drmn4ea/mosquino.hardware/shield-gps/bom/shield-gps.xls

C:/Data/projects/mosquino/pcb/shield-gps/shield-gps.sch | 1/12/2015 10:54:26 PM | Mide Technology Corporation
Qty | Parts (Ref Des.) | Device | Value | ID (bag/kit#) | Manufacturer Part Number | Vendor Part Number | RoHS | Pop. Qty | Unit Cost: Qty1 | Unit Cost: Qty25 | Unit Cost: Qty100 | Unit Cost: Qty1000 | Board @ 1 | Board @ 25 | Board @ 100 | Board @ 1000
2 | J1, J2 | MTA08-100 |  |  |  |  |  | 2
2 | C1, C3 | C-EUC0603 | 4.7uF |  |  | 587-1242-1-ND (http://www.digikey.com/product-detail/en/LMK107B7105KA-T/587-1242-1-ND/931019) |  | 2
1 | R1 | R-US_R0603 | 10k |  |  | P10KGCT-ND (http://www.digikey.com/product-detail/en/ERJ-3GEYJ103V/P10KGCT-ND/134717) |  | 1
1 | C2 | C-EUC0603 | 100nF |  |  | 490-1532-1-ND (http://www.digikey.com/product-detail/en/GRM188R71C104KA01D/490-1532-1-ND/587771) |  | 1
1 | ANT1 | A10204_ANTENNA | A10204_ANTENNA |  |  | 627-1024-1-ND |  | 1
3 | R2, R3, R4 | R-US_R0603 | DNP |  |  |  |  | 3
1 | U1 | ISM420X_GPS | ISM420X_GPS |  | ISM420R1-C33 | 1475-1000-ND |  | 1
1 | IC1 | 24AA1025 | M24M01-DFMN6TP |  | M24M01-DFMN6TP | 497-14926-1-ND (http://www.digikey.com/product-detail/en/M24M01-DFMN6TP/497-14926-1-ND/4959874) |  | 1
5 | CTS, R, RTS, T, WO | PTR1PAD1-13 | PTR1PAD1-13 |  |  |  |  | 5
1 | U$1 | VREG_LT1761_SOT23-5 | TC1016-1.85VCTTR |  | TC1016-1.85VCTTR | TC1016-1.85VCTCT-ND (http://www.digikey.com/product-detail/en/TC1016-1.85VCTTR/TC1016-1.85VCTCT-ND/2202006) |  | 1
Totals...
