drmn4ea/mosquino.hardware/pwr-rf/bom/mosquino-power-rf.xls

Qty | Parts (Ref Des.) | Device | Value | ID (bag/kit#) | Manufacturer Part Number | Vendor Part Number | RoHS | Pop. Qty | Unit Cost: Qty1 | Unit Cost: Qty25 | Unit Cost: Qty100 | Unit Cost: Qty1000 | Board @ 1 | Board @ 25 | Board @ 100 | Board @ 1000
1 | J3 | MTA02-100 |  |  |  |  |  | 1
2 | J1, J2 | MTA05-100 |  |  |  |  |  | 2
5 | C2, C4, C6, C8, C10 | C-EUC0603 | 7pF |  | C1608C0G1H070C080AA | 445-5040-1-ND |  | 5
4 | C3, C5, C7, C9 | C-EUC0603 | 10pF |  | CL10C100JB8NNNC | 1276-1027-1-ND |  | 4
1 | C11 | C-EUC0805 | 10uF |  | CC0805ZKY5V6BB106 | 311-1355-1-ND |  | 1
1 | L1 | INDUCTOR0603 | 6.8nH |  | ELJ-RE6N8JFA | PCD1971CT-ND |  | 1
1 | D7 | DIODE-SOD523 | ESD5Z3.3T1 (DNP) |  | ESD5Z3.3T1G | ESD5Z3.3T1GOSCT-ND |  | 1
5 | D1, D2, D3, D4, D5 | DIODE_DUAL_ACACSOT323 | HSMS-285C |  | HSMS-285C-BLKG | 516-2558-ND |  | 5
1 | LED1 | LEDCHIP-LED0603 | LTST-C191TBKT |  | LTST-C191TBKT | 160-1647-1-ND |  | 1
1 | LOGO1 | OSHW-LOGOS | OSHW-LOGOS |  | n/a |  |  | 0
3 | VCP, VCP2, VOUT | PTR1PAD1-13 | PTR1PAD1-13 |  | n/a |  |  | 0
1 | D6 | DIODE-SOD523 | RB751S40 |  | RB751S40 | RB751S40CT-ND |  | 1
3 | C12, C13, C14 | CAP_TANT_D | RVA0J101MNG |  | RVA0J101MNG | 493-6670-1-ND |  | 3
2 | J4, J5 | SJ_2S | SJ_2S |  |  |  |  | 0
1 | C1 | C-TRIMM3018_12 | TZB4R200BA10R00 |  | TZB4R200BA10R00 | 490-1981-1-ND (FIXME: NON STOCK) |  | 1
1 | U2 | S-882Z | s-882z |  |  |  |  | 0
Totals...
