drmn4ea/mosquino.hardware/shield-ble/bom/shield-ble.xls

Qty | Parts (Ref Des.) | Device | Value | ID (bag/kit#) | Manufacturer Part Number | Vendor Part Number | RoHS | Pop. Qty | Unit Cost: Qty1 | Unit Cost: Qty25 | Unit Cost: Qty100 | Unit Cost: Qty1000 | Board @ 1 | Board @ 25 | Board @ 100 | Board @ 1000
2 | J1, J5 | MTA08-100 |  |  |  |  |  | 2
1 | C4 | C-EUC0603 | 1.2pF |  | CL10C1R2CB8NNNC | 1276-1186-1-ND |  | 1
1 | C5 | C-EUC0603 | 1.8pF |  | CL10C1R8CB8NNNC | 1276-2218-1-ND |  | 1
1 | C7 | C-EUC0603 | 1nF |  | CL10B102KB8SFNC | 1276-1916-1-ND |  | 1
1 | C3 | C-EUC0603 | 1uF |  | CL10F105ZP8NNNC | 1276-1041-1-ND |  | 1
1 | C12 | C-EUC0603 | 2.2nF |  | C0603C222K5RACTU | 399-1085-1-ND |  | 1
1 | L3 | L-GENERIC0603 | 3.9nH |  | ELJ-RE3N9JFA | PCD1968CT-ND |  | 1
1 | C6 | C-EUC0603 | 4.7uF |  | CC0603KRX5R6BB475 | 311-1455-1-ND |  | 1
1 | L5 | L-GENERIC0603 | 5.6nH |  | ELJ-RE5N6JFA | PCD1970CT-ND |  | 1
1 | X2 | CRYSTAL_SMD_5X3POINT2MM | 7A-16.000MAAE-T |  | NX5032GB-16MHZ-STD-CSK-5 | 644-1192-1-ND |  | 1
1 | L4 | L-GENERIC0603 | 8.2nH |  | ELJ-RE8N2JFA | PCD1972CT-ND |  | 1
1 | L1 | L-GENERIC0603 | 10uH |  | CBMF1608T100K | 587-1720-1-ND |  | 1
2 | C1, C2 | C-EUC0603 | 10pF |  | C1608C0G1H100D080AA | 445-1269-1-ND |  | 2
1 | L2 | L-GENERIC0603 | 15nH |  | CI160808-15NJ | CI160808-15NJCT-ND |  | 1
2 | C10, C14 | C-EUC0603 | 22pF |  | CL10C220GB8NNNC | 1276-2225-1-ND |  | 2
1 | R1 | R-US_R0603 | 22k |  | ERJ-3EKF2202V | P22.0KHCT-ND |  | 1
1 | C9 | C-EUC0603 | 33nF |  | CC0603KRX7R9BB333 | 311-1429-1-ND |  | 1
2 | C8, C13 | C-EUC0603 | 100nF |  | CL10F104ZA8NNNC | 1276-1011-1-ND |  | 2
1 | X1 | ANTENNA_CHIP_5MMX2MM | 2450AT42B100E |  | 2450AT42B100E | 712-1008-1-ND |  | 1
1 | C11 | C-EUC0603 | DNP |  |  |  |  | 1
1 | X3 | FC-135 | FC-135 32.7680KA-A3 |  | FC-135 32.7680KA-A3 | SE2413CT-ND |  | 1
1 | U1 | NRF8001_QFN32 | NRF8001_QFN32 |  | nRF8001-R2Q32-T | 949-NRF8001-R2Q32-T (Mouser) |  | 1
1 | LOGO1 | OSHW-LOGOS | OSHW-LOGOS |  |  |  |  | 1
2 | R, T | PTR1PAD1-13 | PTR1PAD1-13 |  |  |  |  | 2
3 | J2, J3, J4 | SJ_2S | SJ_2S |  |  |  |  | 3
Totals...
