drmn4ea/mosquino.hardware/shield-santa/bom/shield-i2c-santa.xls

Qty | Parts (Ref Des.) | Device | Value | ID (bag/kit#) | Manufacturer Part Number | Vendor Part Number | RoHS | Pop. Qty | Unit Cost: Qty1 | Unit Cost: Qty25 | Unit Cost: Qty100 | Unit Cost: Qty1000 | Board @ 1 | Board @ 25 | Board @ 100 | Board @ 1000
3 | J1, J2, J3 | MTA08-100 |  |  |  |  |  | 3
2 | R1, R2 | R-US_R0603 | 1M |  | ERJ-3GEYJ105V | P1.0MGCT-ND |  | 2
7 | C2, C3, C4, C5, C6, C7, C8 | C-EUC0603 | 100nF |  | CL10F104ZA8NNNC | 1276-1011-1-ND |  | 7
1 | C1 | C-EUC0603 | 220nF |  | CC0603KRX7R7BB224 | 311-1426-1-ND |  | 1
1 | U5 | ADXL345 | ADXL345 |  | ADXL345BCCZ | ADXL345BCCZ-ND |  | 1
1 | U2 | CC2DXXX | CC2D23S / CC2D33S |  | CC2D23S | 235-1335-ND |  | 1
1 | U4 | MPL3115A2 | MPL3115A2 |  | MPL3115A2 | MPL3115A2-ND |  | 1
1 | LOGO1 | OSHW-LOGOS | OSHW-LOGOS |  |  |  |  | 0
1 | U8 | TMP006 | TMP006 |  | TMP006AIYZFR | 296-28819-1-ND |  | 1
2 | U6, U7 | TMP101 | TMP101 |  | TMP101NA | 296-27725-1-ND |  | 2
2 | U1, U3 | TMP102 | TMP102/TMP112 |  | TMP102AIDRLR | 296-26834-1-ND |  | 2
Totals...
