drmn4ea/mosquino.hardware/shield-ant/bom/shield-ant.xls

Qty | Parts (Ref Des.) | Device | Value | ID (bag/kit#) | Manufacturer Part Number | Vendor Part Number | RoHS | Pop. Qty | Unit Cost: Qty1 | Unit Cost: Qty25 | Unit Cost: Qty100 | Unit Cost: Qty1000 | Board @ 1 | Board @ 25 | Board @ 100 | Board @ 1000
1 | C1 | C-EUC0805 | 100nF |  | GRM21BR71E104KA01L | 490-1673-1-ND |  | 1
2 | J1, J2 | MTA08-100 |  |  |  |  |  | 2
1 | U1 | ANT21TRXXX | ANTAP2 |  | ANTAP281M4IB | ANTAP281M4IB (Nu Horizons) |  | 1
2 | IO5, IO7 | PTR1TP15R | PTR1TP15R |  |  |  |  | 2
1 | J3 | SJ_2S | SJ_2S |  |  |  |  | 1
5 | J4, J5, J6, J7, J8 | SJ_3S | SJ_3S |  |  |  |  | 5
Totals...
