drmn4ea/mosquino.hardware/pwr-stepup-ti/bom/mosquino-pwr-stepup-ti.xls

Qty | Parts (Ref Des.) | Device | Value | ID (bag/kit#) | Manufacturer Part Number | Vendor Part Number | RoHS | Pop. Qty | Unit Cost: Qty1 | Unit Cost: Qty25 | Unit Cost: Qty100 | Unit Cost: Qty1000 | Board @ 1 | Board @ 25 | Board @ 100 | Board @ 1000
1 | J4 | MTA03-100 |  |  |  |  |  | 1
2 | J1, J2 | MTA05-100 |  |  |  |  |  | 2
1 | R7 | R-US_R0805 | 3.32M |  | RC0805FR-073M32L | 311-3.32MCRCT-ND |  | 1
1 | R5 | R-US_R0805 | 3.83M |  | CRCW08053M83FKEA | 541-3.83MCCT-ND |  | 1
2 | C2, C9 | C-EUC0805 | 4.7uF |  | GRM21BF51A475ZA01L | 490-1745-1-ND |  | 2
2 | R2, R3 | R-US_R0805 | 4.99M |  | RC0805FR-074M99L | 311-4.99MCRCT-ND |  | 2
1 | R4 | R-US_R0805 | 5.62M |  | RC0805FR-075M62L | 311-5.62MCRCT-ND |  | 1
2 | R6, R8 | R-US_R0805 | 6.19M |  | RC0805FR-076M19L | 311-6.19MCRCT-ND |  | 2
1 | C10 | C-EUC0805 | 10nF |  | C2012X7R1H103K | 445-1348-1-ND |  | 1
1 | R1 | R-US_R0805 | 15M |  | ERJ-6GEYK156V | P15MACT-ND |  | 1
1 | R9 | R-US_R0805 | 549K |  | ERJ-6ENF5493V | P549KCCT-ND |  | 1
1 | U1 | BQ25504 | BQ25504 |  | BQ25504RGTT | 296-29741-1-ND |  | 1
1 | T1 | NMOSSOT23 | IRFML8244TRPBF |  | IRFML8244TRPBF | IRFML8244TRPBFCT-ND |  | 1
1 | J5 | SJ_2S | SJ_2S |  |  |  |  | 1
1 | J3 | SJ_3S | SJ_3S |  |  |  |  | 1
1 | L1 | SDR0604 | 22uH |  | SRR5028-220Y | SRR5028-220YCT-ND |  | 1
1 | VOC | TPB1,27 | TPB1,27 |  |  |  |  | 0
Totals...
NOTE: BOM assumes solar input (MPPT=~0.8) and a LiPol or equivalent battery as storage device. For other configurations, please refer to the schematic for appropriate resistor values.
