drmn4ea/mosquino.hardware/pwr-stepup/bom/mosquino-power-stepup.xls

Qty | Parts (Ref Des.) | Device | Value | ID (bag/kit#) | Manufacturer Part Number | Vendor Part Number | RoHS | Pop. Qty | Unit Cost: Qty1 | Unit Cost: Qty25 | Unit Cost: Qty100 | Unit Cost: Qty1000 | Board @ 1 | Board @ 25 | Board @ 100 | Board @ 1000
1 | U2 | MAX9120 |  |  | MAX9120EXK+T | MAX9120EXK+TCT-ND |  | 0
1 | J3 | MTA03-100 |  |  |  |  |  | 1
2 | J1, J2 | MTA05-100 |  |  |  |  |  | 2
1 | L1 | SDR0604 |  |  | 744052100 | 732-1035-1-ND |  | 1
2 | R2, R4 | R-US_R0805 | 0 |  | ERJ-6GEY0R00V | P0.0ACT-ND |  | 2
1 | R8 | R-US_R0805 | 2.55M |  | RC0805FR-072M55L | 311-2.55MCRCT-ND |  | 1
2 | R3, R6 | R-US_R0805 | 4.7M |  | ERJ-6GEYJ475V | P4.7MACT-ND |  | 2
2 | C1, C2 | C-EUC1206 | 22uF |  | C3216Y5V1A226Z | 445-1393-1-ND |  | 2
3 | C3, C4, C5 | C-EUC0805 | 100nF |  | GRM21BR71E104KA01L | 490-1673-1-ND |  | 3
1 | T1 | NMOSSOT23 | IRFML8244TRPBF |  | IRFML8244TRPBF | IRFML8244TRPBFCT-ND |  | 1
2 | R1, R5 | R-US_R0805 | DNP |  |  |  |  | 2
1 | U1 | L6920 | L6920DTR |  | L6920DTR | 497-3368-1-ND |  | 1
1 | IC1 | OPA344N-SOT23 |  |  | MCP6546T-I/OT | MCP6546T-I/OTCT-ND |  | 1
1 | D1 | DIODE-SOD123 | MMSD301T1G |  | MMSD301T1G | MMSD301T1GOSCT-ND |  | 1
1 | D2 | ZENER-DIODESOD80C | zener 3.6V |  | BZV55C3V6-TP | BZV55C3V6-TPMSCT-ND |  | 1
Totals...
