drmn4ea/mosquino.hardware/pwr-lipol/bom/mosquino-power-lipol.xls

Qty | Parts (Ref Des.) | Device | Value | ID (bag/kit#) | Manufacturer Part Number | Vendor Part Number | RoHS | Pop. Qty | Unit Cost: Qty1 | Unit Cost: Qty25 | Unit Cost: Qty100 | Unit Cost: Qty1000 | Board @ 1 | Board @ 25 | Board @ 100 | Board @ 1000
1 | BAT | MTA02-100 |  |  |  |  |  | 1
2 | D1, D2 | CGRM4001-G | 1n4148 |  | CGRM4001-G | 641-1328-2-ND |  | 2
4 | J1, J2, J3, J4 | 100MIL_5X1_PTH | 100MIL_5X1_PTH |  |  |  |  | 4
1 | C1 | C-EUC0805 | 100nF |  | GRM21BR71E104KA01L | 490-1673-1-ND |  | 1
1 | R1 | R-US_R0805 | 180 |  | ERJ-6GEYJ181V | P180ACT-ND |  | 1
1 | T1 | NMOSSOT23 | IRFML8244TRPBF |  | IRFML8244TRPBF | IRFML8244TRPBFCT-ND |  | 1
1 | U1 | LTC4071MS8E | LTC4071MS8E |  | LTC4071EMS8E#PBF | LTC4071EMS8E#PBF-ND |  | 1
1 | B1 | PGEB201515_BATTERY | PGEB201515_BATTERY |  |  |  |  | 1
1 | J5 | SJ_2S | SJ_2S |  |  |  |  | 1
2 | J6, J7 | SJ_3S | SJ_3S |  |  |  |  | 2
Totals...
