drmn4ea/mosquino.hardware/pwr-pelt/bom/mosquino-pwr-peltier.xls

Qty | Parts (Ref Des.) | Device | Value | ID (bag/kit#) | Manufacturer Part Number | Vendor Part Number | RoHS | Pop. Qty | Unit Cost: Qty1 | Unit Cost: Qty25 | Unit Cost: Qty100 | Unit Cost: Qty1000 | Board @ 1 | Board @ 25 | Board @ 100 | Board @ 1000
1 | J5 | MTA02-100 |  |  |  |  |  | 0 |  |  |  |  | 0 | 0 | 0 | 0
2 | J1, J2 | MTA05-100 |  |  | PEC36SAAN | S1012E-36-ND |  | 0.33 | 1.17 | 1.046 | 0.861 | 0.58425 | 0.3861 | 0.34518 | 0.28413 | 0.1928025
2 | C3, C7 | C-EUC0603 | 1nF |  | GRM188R71H102KA01D | 490-1494-1-ND |  | 2 |  |  |  |  | 0 | 0 | 0 | 0
1 | C9 | C-EUC0603 | 1uF |  | C1608Y5V1A105Z | 445-1328-1-ND |  | 1 |  |  |  |  | 0 | 0 | 0 | 0
2 | C5, C6 | C-EUC0805 | 22uF |  | GRM21BR60J226ME39L | 490-1719-1-ND |  | 2 |  |  |  |  | 0 | 0 | 0 | 0
2 | C4, C8 | C-EUC0603 | 470pF |  | C1608X7R1H471K | 445-1307-1-ND |  | 2 |  |  |  |  | 0 | 0 | 0 | 0
1 | C1 | CPOL-USD | DNP |  |  |  |  | 1 |  |  |  |  | 0 | 0 | 0 | 0
2 | L1, L2 | LPR6235_COIL | LPR6235-752SML |  | LPR6235-752SMLB | (buy.coilcraft.com) |  | 2 | 1.06 | 1.06 | 1.06 | 0.74 | 2.12 | 2.12 | 2.12 | 1.48
1 | U1 | LTC3109GN | LTC3109GN |  | LTC3109IGN#PBF | (linear.com) |  | 1 | 6.64 | 6.64 | 5.65 | 5.65 | 6.64 | 6.64 | 5.65 | 5.65
2 | V, VE | TPTP09R | TPTP09R |  |  |  |  | 0 |  |  |  |  | 0 | 0 | 0 | 0
1 | T1 | NMOSSOT23 | IRFML8244TRPBF |  | IRFML8244TRPBF | IRFML8244TRPBFCT-ND |  | 1 | 0.41 | 0.23 | 0.1491 | 0.11411 | 0.41 | 0.23 | 0.1491 | 0.11411
Totals...
16 |  |  |  |  |  |  |  | 11.33 | 9.28 | 8.976 | 7.7201 | 7.08836 | 9.5561 | 9.33518 | 8.20323 | 7.4369125
