drmn4ea/mosquino.hardware/pwr-piezo/bom/mosquino-pwr-piezo.xls

Qty | Parts (Ref Des.) | Device | Value | ID (bag/kit#) | Manufacturer Part Number | Vendor Part Number | RoHS | Pop. Qty | Unit Cost: Qty1 | Unit Cost: Qty25 | Unit Cost: Qty100 | Unit Cost: Qty1000 | Board @ 1 | Board @ 25 | Board @ 100 | Board @ 1000
3 | J3, J4, J5 | MTA03-100 |  |  |  |  |  | 3 |  |  |  |  | 0 | 0 | 0 | 0
2 | J1, J2 | MTA05-100 |  |  | PEC36SAAN | S1012E-36-ND |  | 0.33 |  |  |  |  | 0 | 0 | 0 | 0
2 | C2, C6 | C-EUC0805 | 1uF |  | GRM219F51E105ZA01D | 490-1731-1-ND |  | 2 |  |  |  |  | 0 | 0 | 0 | 0
1 | C3 | C-EUC0805 | 4.7uF |  | C2012Y5V1C475Z | 445-1369-1-ND |  | 1 | 0.556 | 0.3712 | 0.265 | 0.1696 | 0.556 | 0.3712 | 0.265 | 0.1696
1 | C4 | C-EUC0805 | 47uF |  | JMK212BJ476MG-T | 587-1779-1-ND |  | 1 | 1.07 | 0.893 | 0.6555 | 0.418 | 1.07 | 0.893 | 0.6555 | 0.418
1 | C1 | CPOL-USD | 100uF 25V |  | UCL1E101MCL1GS | 493-3937-1-ND |  | 1 | 0.61 | 0.509 | 0.3192 | 0.2508 | 0.61 | 0.509 | 0.3192 | 0.2508
1 | L1 | INDUCTOR1210 | BRL3225T100K |  | BRL3225T100K | 587-2167-1-ND |  | 1 | 0.58 | 0.457 | 0.275 | 0.1375 | 0.58 | 0.457 | 0.275 | 0.1375
1 | C5 | C-EUC0805 | DNP |  |  |  |  | 1 |  |  |  |  | 0 | 0 | 0 | 0
1 | U3 | LTC3588_ | LTC3588_ |  | LTC3588EMSE-1#PBF | LTC3588EMSE-1#PBF-ND |  | 1 | 6.28 | 4.22 | 3.58 | 3.58 | 6.28 | 4.22 | 3.58 | 3.58
1 | T1 | NMOSSOT23 | IRFML8244TRPBF |  | IRFML8244TRPBF | IRFML8244TRPBFCT-ND |  | 1 | 0.5 | 0.2896 | 0.2335 | 0.10508
Totals...
13 |  |  |  |  |  |  |  | 11.33 | 9.096 | 6.4502 | 5.0947 | 4.5559 | 9.096 | 6.4502 | 5.0947 | 4.5559
