drmn4ea/mosquino.hardware/main/bom/mosquino.xls

Qty | Parts (Ref Des.) | Device | Value | ID (bag/kit#) | Manufacturer Part Number | Vendor Part Number | RoHS | Pop. Qty | Unit Cost: Qty1 | Unit Cost: Qty25 | Unit Cost: Qty100 | Unit Cost: Qty1000 | Board @ 1 | Board @ 25 | Board @ 100 | Board @ 1000
1 | B100 | BK885_CR1225_COIN_BATTERY_HOLDER_SMD |  |  | BK-885-TR | BK-885-CT-ND |  | 1 | 0.48 | 0.4 | 0.32 | 0.32 | 0.48 | 0.4 | 0.32 | 0.32
1 | J8 | MTA03-100 |  |  |  |  |  | 1 |  |  |  |  | 0 | 0 | 0 | 0
2 | J6, J9 | MTA05-100 |  |  |  |  |  | 2 |  |  |  |  | 0 | 0 | 0 | 0
9 | J3, J4, J5, J10, J11, J12, J13, J14, J15 | MTA08-100 |  |  |  |  |  | 9 |  |  |  |  | 0 | 0 | 0 | 0
1 | RESET-EN | SJ |  |  |  |  |  | 1 |  |  |  |  | 0 | 0 | 0 | 0
1 | F1 | R-US_R0805 | 0_FUSE |  | 0ZCE0050FF2E | 507-1519-1-ND |  | 1 | 0.39 | 0.35 | 0.25 | 0.15 | 0.39 | 0.35 | 0.25 | 0.15
1 | R2 | R-US_R0805 | 1.8M |  | ERJ-6ENF1804V | P1.80MCCT-ND |  | 1 | 0.07 | 0.07 | 0.02 | 0.01 | 0.07 | 0.07 | 0.02 | 0.01
3 | R1, R19, R20 | R-US_R0805 | 1k |  | ERJ-6ENF1001V | P1.00KCCT-ND |  | 3 |  |  |  |  | 0 | 0 | 0 | 0
1 | D2 | DIODE-SOD123 | 1n4148 |  | 1N4148W-TP | 1N4148WTPMSCT-ND |  | 1 | 0.42 | 0.28 | 0.12 | 0.04 | 0.42 | 0.28 | 0.12 | 0.04
1 | C7 | C-EUC0805 | 1uF |  | C2012Y5V1C105Z/0.85 | 445-1589-1-ND |  | 1 | 0.2 | 0.13 | 0.05 | 0.02 | 0.2 | 0.13 | 0.05 | 0.02
1 | R12 | R-US_R0805 | 3.0M |  | RMCF0805FT3M00 | RMCF0805FT3M00CT-ND |  | 1 |  |  |  |  | 0 | 0 | 0 | 0
1 | R3 | R-US_R0805 | 3.65M |  | RC0805FR-073M65L | 311-3.65MCRCT-ND |  | 1 |  |  |  |  | 0 | 0 | 0 | 0
6 | R9, R10, R13, R14, R15, R16 | R-US_R0805 | 4.7M |  | ERJ-6GEYJ475V | P4.7MACT-ND |  | 6 |  |  |  |  | 0 | 0 | 0 | 0
1 | R8 | R-US_R0805 | 6.04M |  | RC0805FR-076M04L | 311-6.04MCRCT-ND |  | 1 |  |  |  |  | 0 | 0 | 0 | 0
2 | R17, R18 | R-US_R0805 | 10k |  | ERJ-6GEYJ103V | P10KACT-ND |  | 2 |  |  |  |  | 0 | 0 | 0 | 0
2 | C6, C13 | C-EUC0805 | 10nF |  | 08055C103KAT2A | 478-1383-1-ND |  | 2 | 0.03 | 0.03 | 0.02 | 0.01 | 0.06 | 0.06 | 0.03 | 0.01
1 | C14 | C-EUC0805K | 10uF |  | C2012Y5V1A106Z | 445-1371-1-ND |  | 1 | 0.32 | 0.21 | 0.08 | 0.03 | 0.32 | 0.21 | 0.08 | 0.03
2 | R4, R5 | R-US_R0805 | 15M |  | ERJ-6GEYK156V | P15MACT-ND |  | 2 |  |  |  |  | 0 | 0 | 0 | 0
2 | C2, C3 | C-EUC0805K | 22pF |  | CC0805JRNP09BN220 | 311-1103-1-ND |  | 2 | 0.08 | 0.08 | 0.05 | 0.02 | 0.16 | 0.16 | 0.09 | 0.03
1 | C1 | CPOL-USD | 47uF |  | EMVY160ADA470MF55G | 565-2445-1-ND |  | 1 | 0.48 | 0.32 | 0.23 | 0.15 | 0.48 | 0.32 | 0.23 | 0.15
3 | R6, R7, R11 | R-US_R0805 | 100k |  | ERJ-6GEYJ104V | P100KACT-ND |  | 3 |  |  |  |  | 0 | 0 | 0 | 0
7 | C4, C5, C8,C9, C10, C11, C12 | C-EUC0805 | 100nF |  | GRM21BR71E104KA01L | 490-1673-1-ND |  | 7 |  |  |  |  | 0 | 0 | 0 | 0
1 | X1 | CRYSTALSM49 | 8MHz |  | ABLS-8.000MHZ-B4-T | 535-10212-1-ND |  | 1 | 0.41 | 0.36 | 0.25 | 0.21 | 0.41 | 0.36 | 0.25 | 0.21
1 | T5 | NMOSSOT23 | BSH103 |  | BSH103,215 | 568-5013-1-ND |  | 1 | 0.58 | 0.34 | 0.27 | 0.12 | 0.58 | 0.34 | 0.27 | 0.12
1 | D3 | DIODE_ZENER_CZRM27C200P-G | 10V |  | BZT52C10-7-F | BZT52C10-FDICT-ND |  | 1 | 0.38 | 0.26 | 0.12 | 0.05 | 0.38 | 0.26 | 0.12 | 0.05
1 | D1 | DIODE-SOD123 | 15V |  | BZT52C15-7-F | BZT52C15-FDICT-ND |  | 1 | 0.38 | 0.26 | 0.12 | 0.05 | 0.38 | 0.26 | 0.12 | 0.05
3 | T1, T2, T4 | PMOSSOT23 | DMP3098L-7 |  | DMP3098L-7 | DMP3098LDICT-ND |  | 3 | 0.44 | 0.34 | 0.23 | 0.12 | 1.32 | 1.03 | 0.7 | 0.36
1 | U4 | DS1337S | DS1337S |  | DS1337S+ | DS1337S+-ND |  | 1 | 2.73 | 1.82 | 1.32 | 1.17 | 2.73 | 1.82 | 1.32 | 1.17
1 | RESET | EVQ_TACT_SW_6X6POINT5 | EVQ_TACT_SW_6X6POINT5 |  | EVQ-Q2U03W | P12955SCT-ND |  | 1 | 0.4 | 0.32 | 0.26 | 0.19 | 0.4 | 0.32 | 0.26 | 0.19
1 | X2 | FC-135 | FC-135 |  | ECS-.327-7-34B-TR | XC1656CT-ND |  | 1 | 1.58 | 1.37 | 0.95 | 0.63 | 1.58 | 1.37 | 0.95 | 0.63
1 | IC2 | FT232RL | FT232RL |  | FT232RL R | 768-1007-1-ND |  | 1 | 4.5 | 4.05 | 3.65 | 2.85 | 4.5 | 4.05 | 3.65 | 2.85
3 | T3, T6, T7 | NMOSSOT23 | IRFML8244TRPBF |  | IRFML8244TRPBF | IRFML8244TRPBFCT-ND |  | 3 | 0.41 | 0.23 | 0.15 | 0.11 | 1.23 | 0.69 | 0.45 | 0.34
2 | U1, U2 | LTC1540ACS8 | LTC1540ACS8 |  | LTC1540IS8#PBF | LTC1540IS8#PBF-ND |  | 2 | 3.5 | 2.32 | 1.9 | 1.9 | 7 | 4.65 | 3.8 | 3.8
1 | U3 | MCP1700T | MCP1700T |  | MCP1703T | MCP1703T-3302E/CBCT-ND |  | 1 | 0.68 | 0.45 | 0.41 | 0.41 | 0.68 | 0.45 | 0.41 | 0.41
1 | IC1 | MEGA323-P | MEGA323-P |  | ATMEGA644PA-PU | ATMEGA644PA-PU-ND |  | 1 | 7.5 | 4.71 | 4.19 | 4.19 | 7.5 | 4.71 | 4.19 | 4.19
1 | J7 | MINI-USB-UX60-MB-5ST | MINI-USB-UX60-MB-5ST |  | UX60-MB-5ST | H2959CT-ND |  | 1 | 1.25 | 0.91 | 0.74 | 0.53 | 1.25 | 0.91 | 0.74 | 0.53
2 | D4, D5 | DIODE-SOD123 | MMSD301T1G |  | MMSD301T1G | MMSD301T1GOSCT-ND |  | 2 | 0.44 | 0.31 | 0.19 | 0.08 | 0.88 | 0.62 | 0.37 | 0.16
1 | SW1 | SW_DPDT_EG1390 | SW_DPDT_EG1390 |  | EG1390 | EG4632CT-ND |  | 1 | 0.74 | 0.63 | 0.53 | 0.46 | 0.74 | 0.63 | 0.53 | 0.46
2 | J1, J2 | TERM_2 | TERM_2 |  | 1990009 | 277-1794-ND |  | 2 | 0.23 | 0.22 | 0.2 | 0.16 | 0.46 | 0.44 | 0.41 | 0.32
1 | TX | LEDCHIP-LED0805 | green |  | APHCM2012CGCK-F01 | 754-1094-1-ND |  | 1 | 0.2 | 0.12 | 0.11 | 0.08 | 0.2 | 0.12 | 0.11 | 0.08
1 | LED1 | LEDCHIP-LED0805 | red |  | APHCM2012SURCK-F01 | 754-1097-1-ND |  | 1 | 0.18 | 0.11 | 0.1 | 0.07 | 0.18 | 0.11 | 0.1 | 0.07
1 | RX | LEDCHIP-LED0805 | yellow |  | APHCM2012SYCK-F01 | 754-1098-1-ND |  | 1 | 0.18 | 0.11 | 0.1 | 0.07 | 0.18 | 0.11 | 0.1 | 0.07
1 | NOT_ON_BOARD | U | Socket |  | 4840-6000-CP | 3M5471-ND |  | 1 | 0.75 | 0.45 | 0.35 | 0.26 | 0.75 | 0.45 | 0.35 | 0.26
Totals... |  |  |  |  |  |  |  |  | 29.93 | 21.52 | 17.27 | 14.43 | 35.91 | 25.62 | 20.39 | 17.06
