drmn4ea/mosquino.hardware/shield-microsd/bom/shield-microsd.xls

Qty | Parts (Ref Des.) | Device | Value | ID (bag/kit#) | Manufacturer Part Number | Vendor Part Number | RoHS | Pop. Qty | Unit Cost: Qty1 | Unit Cost: Qty25 | Unit Cost: Qty100 | Unit Cost: Qty1000 | Board @ 1 | Board @ 25 | Board @ 100 | Board @ 1000
2 | J4, J6 | MTA08-100 |  |  | PEC36SAAN | S1012E-36-ND |  | 2
1 | T1 | PMOSSOT23 |  |  | IRLML6302TRPBF | IRLML6302PBFCT-ND |  | 1
1 | R2 | R-US_R0805 | 4.7M |  | ERJ-6GEYJ475V | P4.7MACT-ND |  | 1
1 | C2 | C-EUC0805 | 100nF |  | GRM21BR71E104KA01L | 490-1673-1-ND |  | 1
1 | U2 | USD-SOCKETNEW | USD-SOCKETNEW |  | Amphenol 101-00660-68-6 | PRT-00127 (Sparkfun) |  | 1
 |  |  |  |  |  | 101-00660-68-6-1-ND (Digikey)
1 | U1 | USD-SOCKETUSD | USD-SOCKETUSD |  |  | PRT-09545 (Sparkfun, DISCONTINUED) |  | 1
Totals...
