drmn4ea/mosquino.hardware/pwr-pjt/bom/mosquino-power-pjt.xls

D:/data/projects/draculino/pcb/pwr-pjt/draculino-power-pjt.sch | 2010-09-06 02:27
Qty | Parts (Ref Des.) | Device | Value | ID (bag/kit#) | Manufacturer Part Number | Vendor Part Number | RoHS | Pop. Qty | Unit Cost: Qty1 | Unit Cost: Qty25 | Unit Cost: Qty100 | Unit Cost: Qty1000 | Board @ 1 | Board @ 25 | Board @ 100 | Board @ 1000
2 | +, - | MTA03-100 |  |  |  |  |  | 2 |  |  |  |  | 0 | 0 | 0 | 0
2 | J1, J2 | MTA05-100 |  |  | PEC36SAAN | S1012E-36-ND |  | 0.33 |  |  |  |  | 0 | 0 | 0 | 0
1 | C5 | C-EUC0805 | 1uF |  | GRM219F51E105ZA01D | 490-1731-1-ND |  | 1 | 0.081 | 0.081 | 0.0481 | 0.01924 | 0.081 | 0.081 | 0.0481 | 0.01924
2 | C1, C2 | CPOL-USD | 330uF |  | EEE-HA0J331XP | PCE4164CT-ND |  | 2 | 0.57 | 0.3408 | 0.2982 | 0.213 | 1.14 | 0.6816 | 0.5964 | 0.426
4 | D1, D2, D3, D4 | DIODE-SOD123 | DFLS130L |  | DFLS130L-7 | DFLS130LDICT-ND |  | 4 | 0.55 | 0.44 | 0.33 | 0.19 | 2.2 | 1.76 | 1.32 | 0.76
2 | J5, J6 | SJ_2S | SJ_2S |  |  |  |  | 2 |  |  |  |  | 0 | 0 | 0 | 0
1 | U2 | S-882Z | s-882z |  | S-882Z24-M5T1G | 11N8276 (Newark) |  | 1 | 2.55 | 2.55 | 2.3 | 1.81 | 2.55 | 2.55 | 2.3 | 1.81
Totals...
14 |  |  |  |  |  |  |  | 12.33 | 3.751 | 3.4118 | 2.9763 | 2.23224 | 5.971 | 5.0726 | 4.2645 | 3.01524
