drmn4ea/mosquino.hardware/shield-kentlcd/bom/shield-kentlcd.xls

C:/Data/projects/draculino/pcb/shield-kentlcd/shield-kentlcd.sch | 9/06/2010 10:28:27p
Qty | Parts (Ref Des.) | Device | Value | ID (bag/kit#) | Manufacturer Part Number | Vendor Part Number | RoHS | Pop. Qty | Unit Cost: Qty1 | Unit Cost: Qty25 | Unit Cost: Qty100 | Unit Cost: Qty1000 | Board @ 1 | Board @ 25 | Board @ 100 | Board @ 1000
2 | J4, J6 | MTA08-100 |  |  | PEC36SAAN | S1012E-36-ND |  | 0.5 |  |  |  |  | 0 | 0 | 0 | 0
2 | C1, C13 | C-EUC0603K | 1uF/16V |  | CC0805KKX7R7BB105 | 311-1365-1-ND |  | 2 | 0.069 | 0.069 | 0.0408 | 0.01633 | 0.138 | 0.138 | 0.0816 | 0.03266
3 | C5, C6, C7 | C-EUC0603K | 1uF/25V |  | GCM21BR71E105KA56L | 490-4785-1-ND |  | 3 | 0.232 | 0.232 | 0.1372 | 0.05486 | 0.696 | 0.696 | 0.4116 | 0.16458
1 | C14 | C-EUC0603K | 1uF/50V |  | UMK212BJ105KG-T | 587-2229-1-ND |  | 1 | 0.39 | 0.26 | 0.104 | 0.039 | 0.39 | 0.26 | 0.104 | 0.039
1 | C3 | C-EUC0603K | 2.2uF/16V |  | C2012X7R1C225K | 445-1420-1-ND |  | 1 | 0.242 | 0.242 | 0.143 | 0.0572 | 0.242 | 0.242 | 0.143 | 0.0572
1 | C4 | C-EUC0603K | 2.2uF/25V |  | TMK212BJ225KG-T | 587-1292-1-ND |  | 1 | 0.35 | 0.275 | 0.1438 | 0.065 | 0.35 | 0.275 | 0.1438 | 0.065
1 | C2 | C-EUC0603K | 4.7uF/10V |  | C0805C475K8PACTU | 399-3133-1-ND |  | 1 | 0.225 | 0.225 | 0.105 | 0.04125 | 0.225 | 0.225 | 0.105 | 0.04125
4 | C9, C10, C11, C12 | C-EUC0603K | 100nF/16V |  | 160R15W104KV4T | 709-1183-1-ND |  | 4 | 0.067 | 0.067 | 0.0397 | 0.01586 | 0.268 | 0.268 | 0.1588 | 0.06344
1 | R1 | R-US_R0603 | 200 |  | RMCF0805FT200R | RMCF0805FT200RCT-ND |  | 1 | 0.04 | 0.029 | 0.0123 | 0.00448 | 0.04 | 0.029 | 0.0123 | 0.00448
1 | C15 | C-EUC0603K | 220nF |  | GRM219R71C224KA01D | 490-1684-1-ND |  | 1 | 0.13 | 0.13 | 0.0769 | 0.03076 | 0.13 | 0.13 | 0.0769 | 0.03076
1 | C8 | C-EUC0603K | 470nF/50V |  | GRM21BR71H474KA88L | 490-3328-1-ND |  | 1 | 0.327 | 0.327 | 0.1931 | 0.07722 | 0.327 | 0.327 | 0.1931 | 0.07722
1 | U1 | KENT_25138B | KENT_25138B |  | 1594101208 | (kentdisplays.com) |  | 1 | 5 | 5 | 5 | 5 | 5 | 5 | 5 | 5
1 | R2 | R-US_R0805 | NCP21WF104J03RA |  | NCP21WF104J03RA | 490-2451-1-ND |  | 1 | 0.21 | 0.184 | 0.1449 | 0.09486 | 0.21 | 0.184 | 0.1449 | 0.09486
Totals...
20 |  |  |  |  |  |  |  | 18.5 | 7.282 | 7.04 | 6.1407 | 5.49682 | 8.016 | 7.774 | 6.575 | 5.67045
