drmn4ea/mosquino.hardware/shield-gps/shield-gps.brd

## EAGLE design shield-gps/shield-gps.brd (2015-02-09)

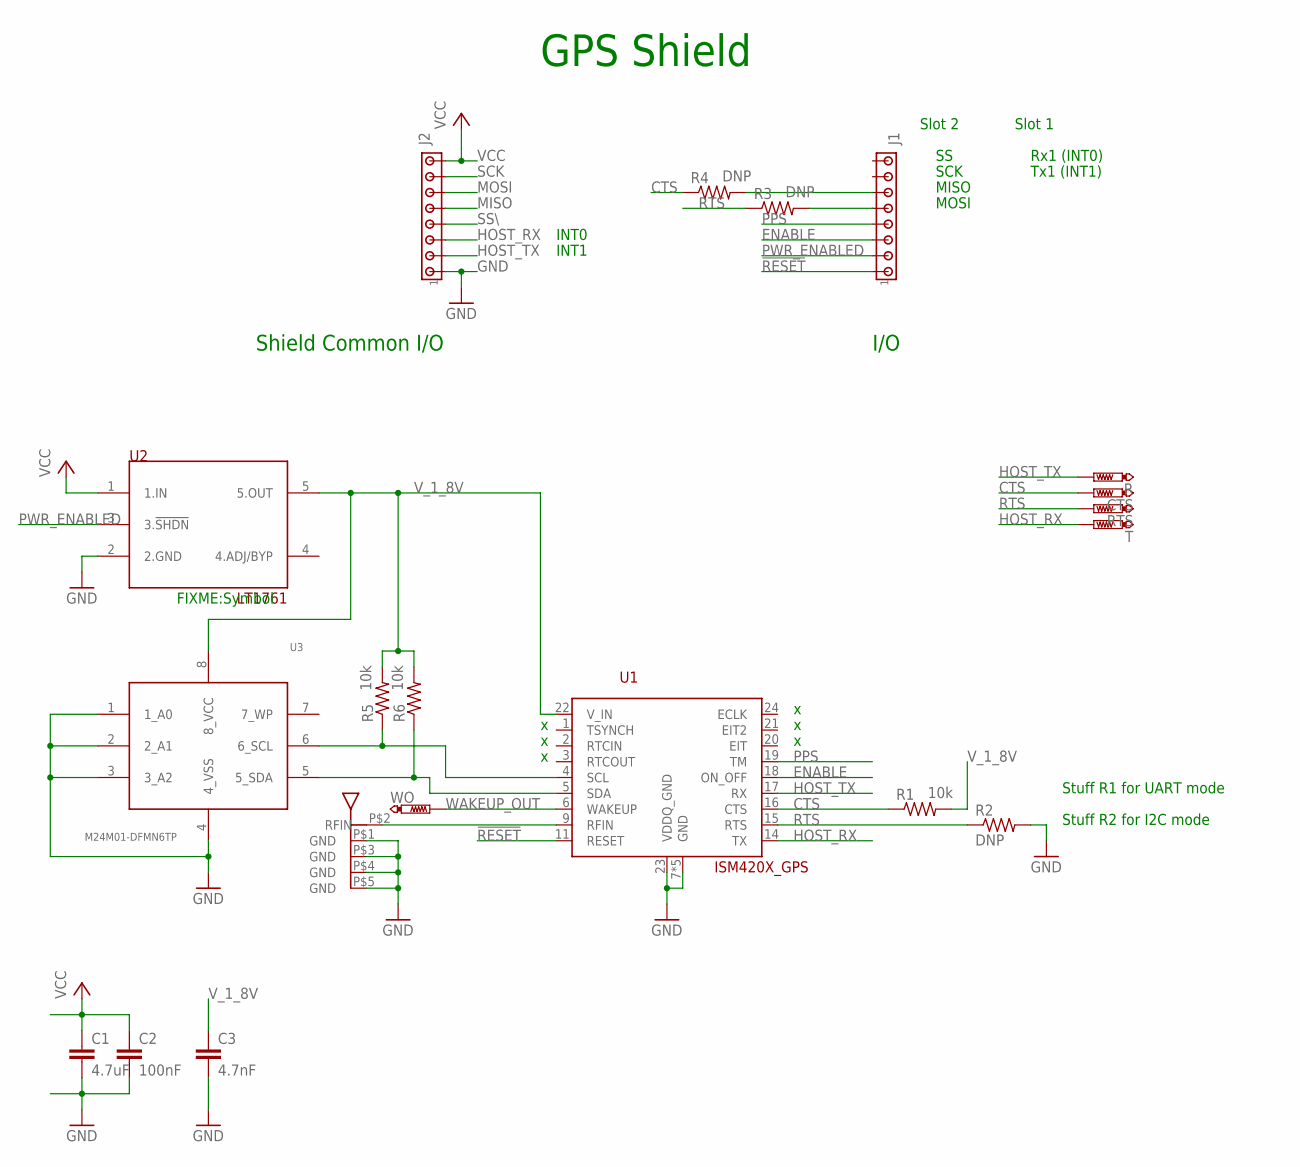
[picture p1: schematic shield-gps.sch]

Parts:
ANT1: A10204_ANTENNA
C1: 4.7uF; C0603
C2: 100nF; C0603
C3: 4.7nF; C0603
CTS: PTR1PAD1-13; P1-13
J1, J2: MTA08-100; 10X08MTA
R: PTR1PAD1-13; P1-13
R1, R5, R6: 10k; R0603
R2, R3, R4: DNP; R0603
RTS: PTR1PAD1-13; P1-13
T: PTR1PAD1-13; P1-13
U1: ISM420X_GPS
U2: TC1016-1.85VCTTR; SOT23-5
U3: M24M01-DFMN6TP; SO-8
WO: PTR1PAD1-13; P1-13

Connections:
!RESET: J1.1, U1.11 (RESET)
CTS: CTS.TP, R1.1, R4.1, U1.16 (CTS)
ENABLE: J1.3, U1.18 (ON_OFF)
GND: ANT1.P$1 (GND), ANT1.P$3 (GND), ANT1.P$4 (GND), ANT1.P$5 (GND), C1.2, C2.2, C3.2, J2.1, R2.2, U1.7 (GND), U1.8 (GND), U1.10 (GND), U1.12 (GND), U1.13 (GND), U1.23 (VDDQ_GND), U2.2 (2.GND), U3.1 (1_A0), U3.2 (2_A1), U3.3 (3_A2), U3.4 (4_VSS)
HOST_RX: J2.3, T.TP, U1.14 (TX)
HOST_TX: J2.2, R.TP, U1.17 (RX)
MISO: J2.5
MOSI: J2.6
unnamed: ANT1.P$2 (RFIN), U1.9 (RFIN)
unnamed: J1.5, R3.2
unnamed: R6.1, U1.5 (SDA), U3.5 (5_SDA)
unnamed: R5.1, U1.4 (SCL), U3.6 (6_SCL)
unnamed: J1.6, R4.2
PPS: J1.4, U1.19 (TM)
PWR_ENABLED: J1.2, U2.3 (3.!SHDN)
RTS: R2.1, R3.1, RTS.TP, U1.15 (RTS)
SCK: J2.7
SS\: J2.4
VCC: C1.1, C2.1, J2.8, U2.1 (1.IN)
V_1_8V: C3.1, R1.2, R5.2, R6.2, U1.22 (V_IN), U2.5 (5.OUT), U3.8 (8_VCC)
WAKEUP_OUT: U1.6 (WAKEUP), WO.TP

Notes on the sheet:
Shield Common I/O
I/O
GPS Shield
SCK
MISO
MOSI
Rx1 (INT0)
Tx1 (INT1)
Slot 2
Slot 1
INT1
INT0
FIXME:Symbol
Stuff R1 for UART mode
Stuff R2 for I2C mode

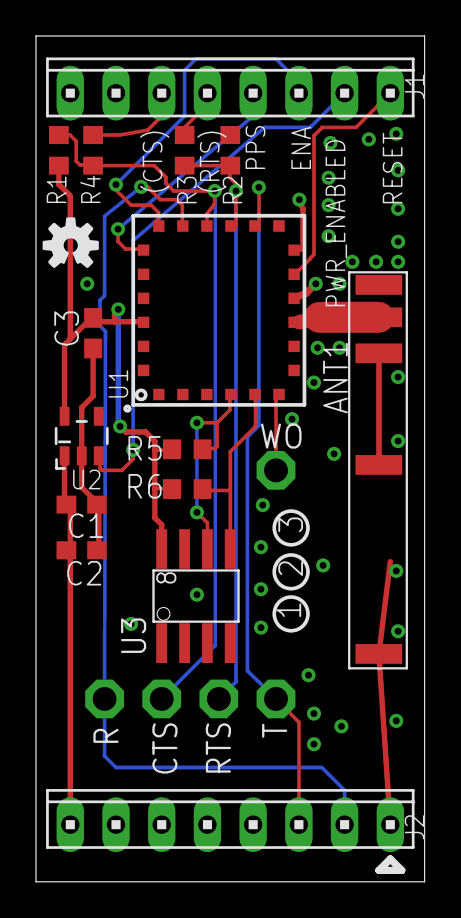
[picture p2: board shield-gps.brd from above]

Board: 2 copper layers, 21.6 x 47.0 mm, 21 parts (0 on the bottom side), 17 nets.

Other parts of the board:
LOGO1: OSHW-LOGOS; OSHW-LOGO-S
