drmn4ea/mosquino.hardware/pwr-rf/mosquino-power-rf.brd

## EAGLE design pwr-rf/mosquino-power-rf.brd (2013-10-14)

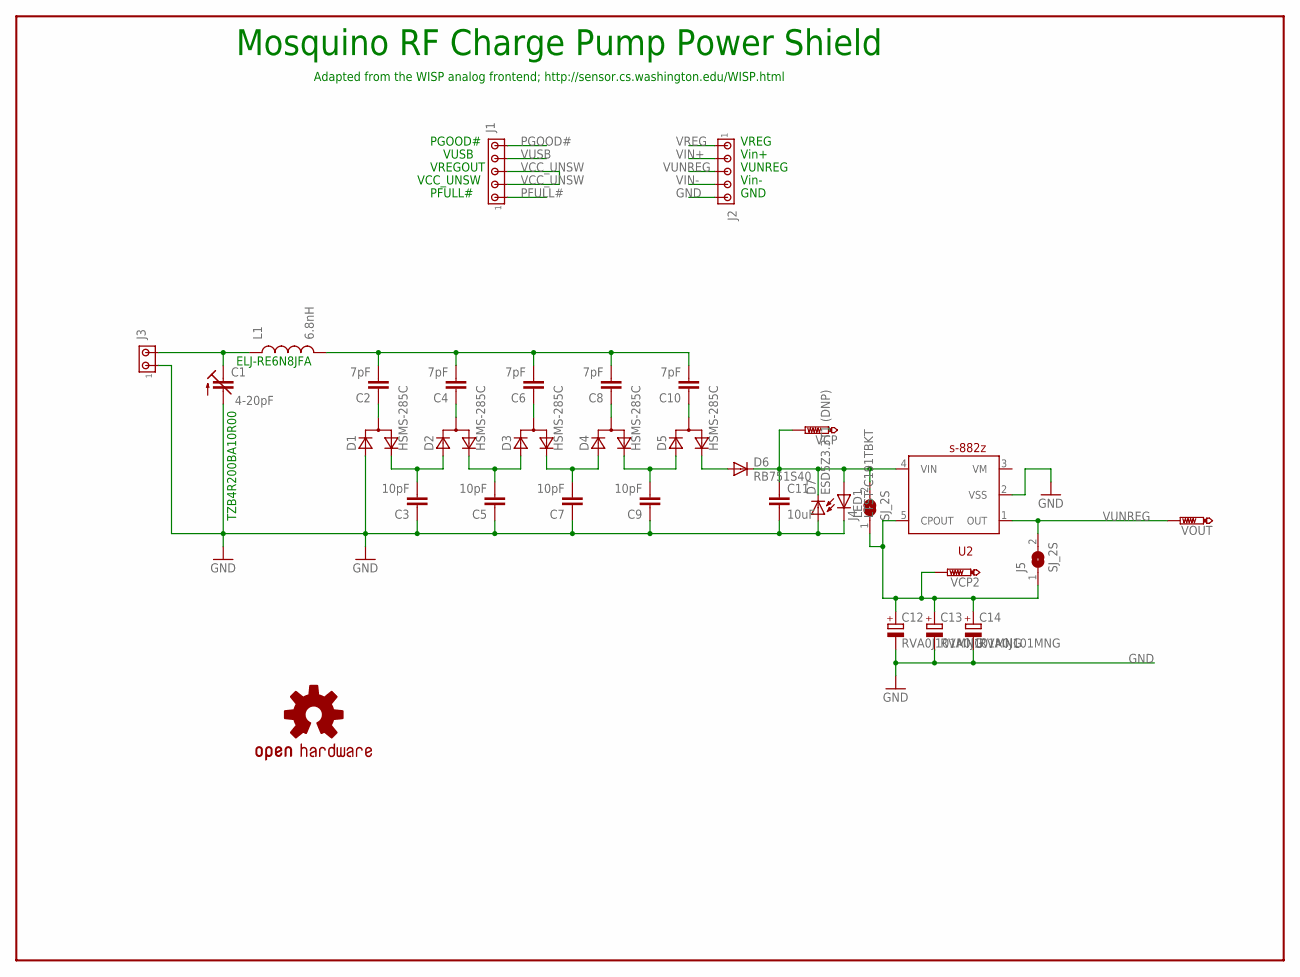
[picture p3: schematic mosquino-power-rf.sch]

Parts:
C1: 4-20pF; CTRIM3018_12
C2, C4, C6, C8, C10: 7pF; C0603
C3, C5, C7, C9: 10pF; C0603
C11: 10uF; C0805
C12, C13, C14: RVA0J101MNG; CASE_D
D1, D2, D3, D4, D5: HSMS-285C; SOT-323
D6: RB751S40; SOD523
D7: ESD5Z3.3T1 (DNP); SOD523
J1, J2: MTA05-100; 10X05MTA
J3: MTA02-100; 10X02MTA
J4, J5: SJ_2S; SJ2_S
L1: 6.8nH; 0603
LED1: LTST-C191TBKT; CHIP-LED0603
LOGO1: OSHW-LOGOS; OSHW-LOGO-S
U2: s-882z; SOT23-5
VCP, VCP2: PTR1PAD1-13; P1-13
VOUT: PTR1PAD1-13; P1-13

Connections:
GND: C1.- (A), C3.1, C5.1, C7.1, C9.1, C11.2, C12.2 (-), C13.2 (-), C14.2 (-), D1.1 (A), D7.A, J2.5, J3.1, LED1.C, U2.2 (VSS)
unnamed: C2.1, D1.3 (CA)
unnamed: C3.2, D1.2 (C), D2.1 (A)
unnamed: C5.2, D2.2 (C), D3.1 (A)
unnamed: C7.2, D3.2 (C), D4.1 (A)
unnamed: C9.2, D4.2 (C), D5.1 (A)
unnamed: C2.2, C4.2, C6.2, C8.2, C10.2, L1.2
unnamed: C4.1, D2.3 (CA)
unnamed: C6.1, D3.3 (CA)
unnamed: C8.1, D4.3 (CA)
unnamed: C10.1, D5.3 (CA)
unnamed: D5.2 (C), D6.A
unnamed: C1.+ (E), J3.2, L1.1
unnamed: C11.1, D6.C, D7.C, J4.2, LED1.A, U2.4 (VIN), VCP.TP
unnamed: C12.1 (+), C13.1 (+), C14.1 (+), J4.1, J5.1, U2.5 (CPOUT), VCP2.TP
PFULL#: J1.1
PGOOD#: J1.5
VCC_UNSW: J1.2, J1.3
VIN+: J2.2
VIN-: J2.4
VREG: J2.1
VUNREG: J2.3, J5.2, U2.1 (OUT), VOUT.TP
VUSB: J1.4

Notes on the sheet:
PGOOD#
Vin+
Vin-
GND
PFULL#
VUSB
VREG
VUNREG
VREGOUT
Mosquino RF Charge Pump Power Shield
VCC_UNSW
Adapted from the WISP analog frontend; http://sensor.cs.washington.edu/WISP.html
ELJ-RE6N8JFA
TZB4R200BA10R00

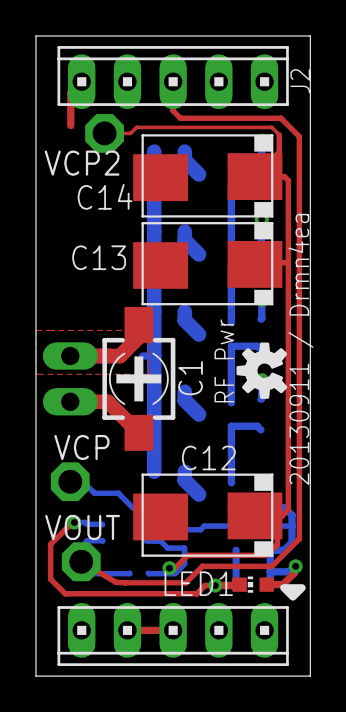
[picture p4: board mosquino-power-rf.brd from above]

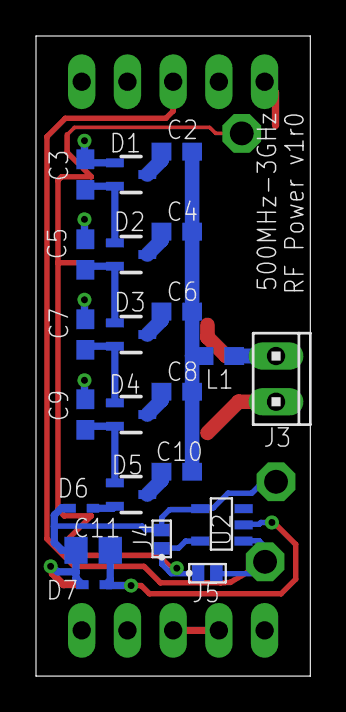
[picture p5: board mosquino-power-rf.brd from below]

Board: 2 copper layers, 15.2 x 35.6 mm, 33 parts (22 on the bottom side), 17 nets.
