drmn4ea/mosquino.hardware/shield-ble/shield-ble.brd

## EAGLE design shield-ble/shield-ble.brd (2013-10-14)

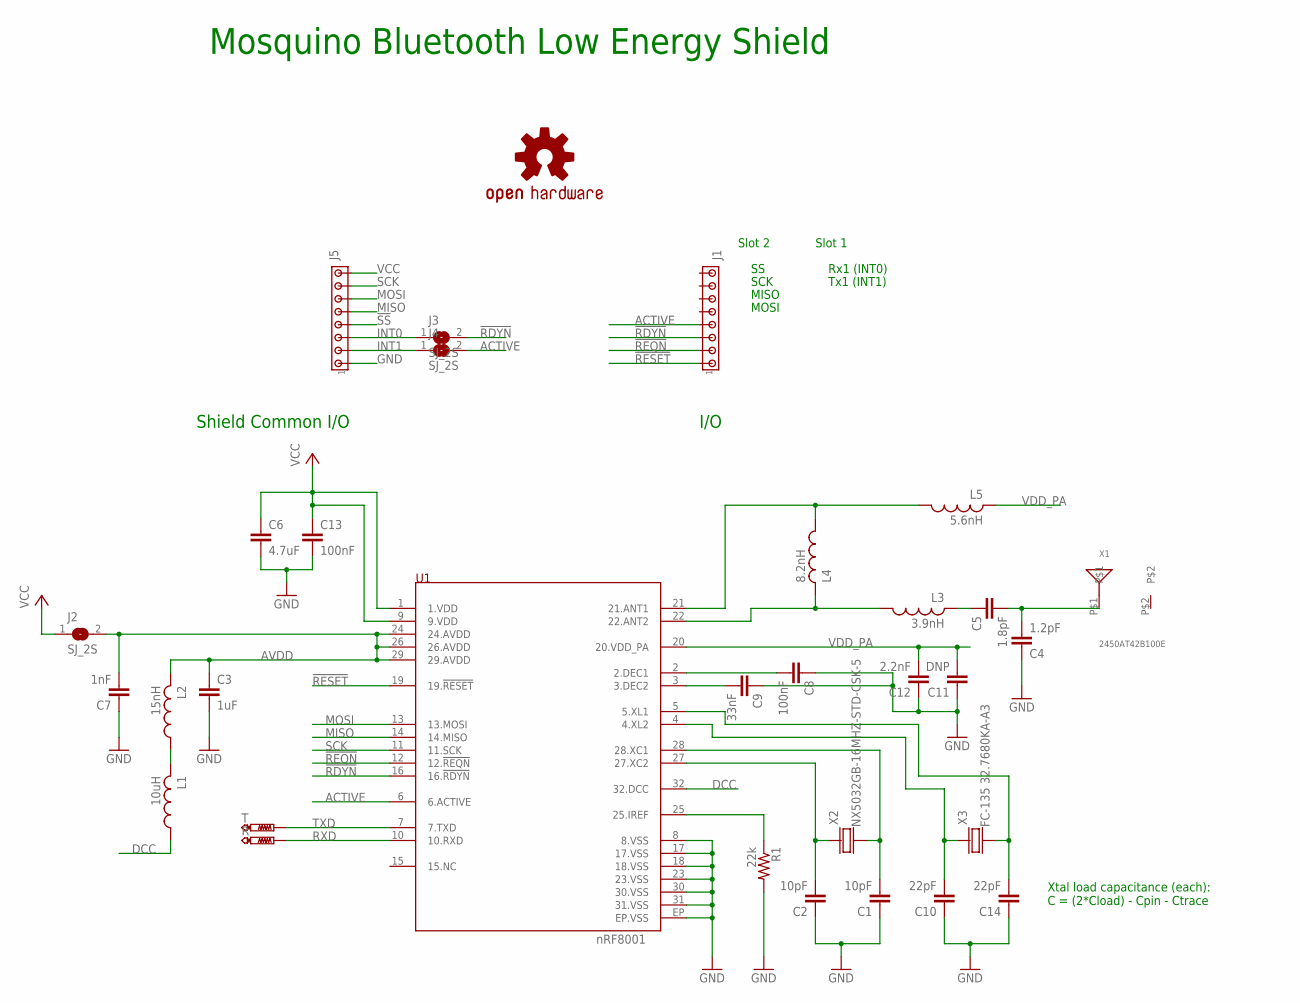
[picture p6: schematic shield-ble.sch]

Parts:
C1, C2: 10pF; C0603
C3: 1uF; C0603
C4: 1.2pF; C0603
C5: 1.8pF; C0603
C6: 4.7uF; C0603
C7: 1nF; C0603
C8, C13: 100nF; C0603
C9: 33nF; C0603
C10, C14: 22pF; C0603
C11: DNP; C0603
C12: 2.2nF; C0603
J1, J5: MTA08-100; 10X08MTA
J2, J3, J4: SJ_2S; SJ2_S
L1: 10uH; 0603
L2: 15nH; 0603
L3: 3.9nH; 0603
L4: 8.2nH; 0603
L5: 5.6nH; 0603
LOGO1: OSHW-LOGOS; OSHW-LOGO-S
R: PTR1PAD1-13; P1-13
R1: 22k; R0603
T: PTR1PAD1-13; P1-13
U1: NRF8001_QFN32; QFN-32
X1: 2450AT42B100E; ANTENNA_CHIP_5MMX2MM
X2: NX5032GB-16MHZ-STD-CSK-5; CRYSTAL_SMD_5X3POINT2MM
X3: FC-135 32.7680KA-A3; FC-135

Connections:
!RDYN: J1.3, J3.2, U1.16 (16.!RDYN)
!REQN: J1.2, U1.12 (12.!REQN)
!RESET: J1.1, U1.19 (19.!RESET)
!SS: J5.4
ACTIVE: J1.4, J4.2, U1.6 (6.ACTIVE)
AVDD: C3.1, C7.2, J2.2, L2.2, U1.24 (24.AVDD), U1.26 (26.AVDD), U1.29 (29.AVDD)
DCC: L1.1, U1.32 (32.DCC)
GND: C1.1, C2.1, C3.2, C4.1, C6.2, C7.1, C8.1, C9.1, C10.1, C11.1, C12.1, C13.2, C14.1, J5.1, R1.2, U1.8 (8.VSS), U1.17 (17.VSS), U1.18 (18.VSS), U1.23 (23.VSS), U1.30 (30.VSS), U1.31 (31.VSS), U1.EP (EP.VSS)
INT0: J3.1, J5.3
INT1: J4.1, J5.2
MISO: J5.5, U1.14 (14.MISO)
MOSI: J5.6, U1.13 (13.MOSI)
unnamed: L1.2, L2.1
unnamed: C2.2, U1.27 (27.XC2), X2.P$1 (X1)
unnamed: C1.2, U1.28 (28.XC1), X2.P$2 (X2)
unnamed: C10.2, U1.4 (4.XL2), X3.P$1 (X1)
unnamed: C14.2, U1.5 (5.XL1), X3.P$2 (X2)
unnamed: C5.1, L3.2
unnamed: L3.1, L4.2, U1.22 (22.ANT2)
unnamed: L4.1, L5.1, U1.21 (21.ANT1)
unnamed: C8.2, U1.2 (2.DEC1)
unnamed: C9.2, U1.3 (3.DEC2)
unnamed: R1.1, U1.25 (25.IREF)
unnamed: C4.2, C5.2, X1.P$1
RXD: R.TP, U1.10 (10.RXD)
SCK: J5.7, U1.11 (11.SCK)
TXD: T.TP, U1.7 (7.TXD)
VCC: C6.1, C13.1, J2.1, J5.8, U1.1 (1.VDD), U1.9 (9.VDD)
VDD_PA: C11.2, C12.2, L5.2, U1.20 (20.VDD_PA)

Notes on the sheet:
Shield Common I/O
I/O
Mosquino Bluetooth Low Energy Shield
SCK
MISO
MOSI
Rx1 (INT0)
Tx1 (INT1)
Slot 2
Slot 1
Xtal load capacitance (each): C = (2*Cload) - Cpin - Ctrace

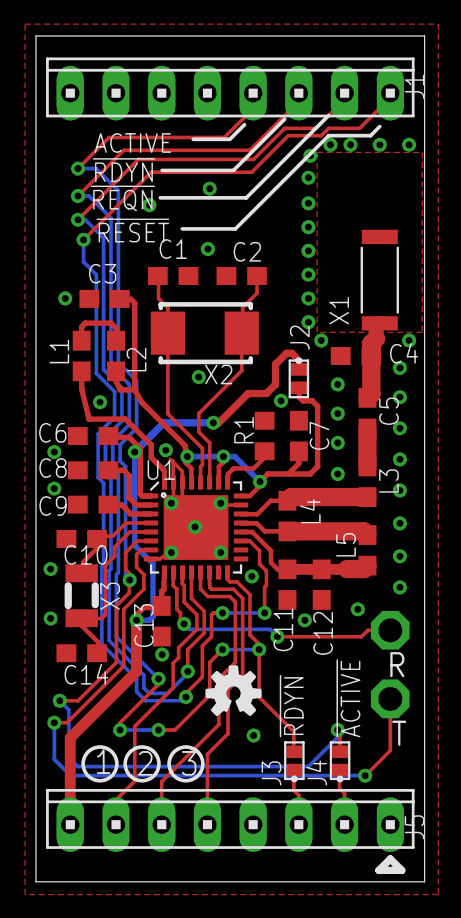
[picture p7: board shield-ble.brd from above]

Board: 2 copper layers, 21.6 x 47.0 mm, 32 parts (0 on the bottom side), 28 nets.
