drmn4ea/mosquino.hardware/shield-santa/shield-i2c-santa.brd

## EAGLE design shield-santa/shield-i2c-santa.brd (2013-10-14)

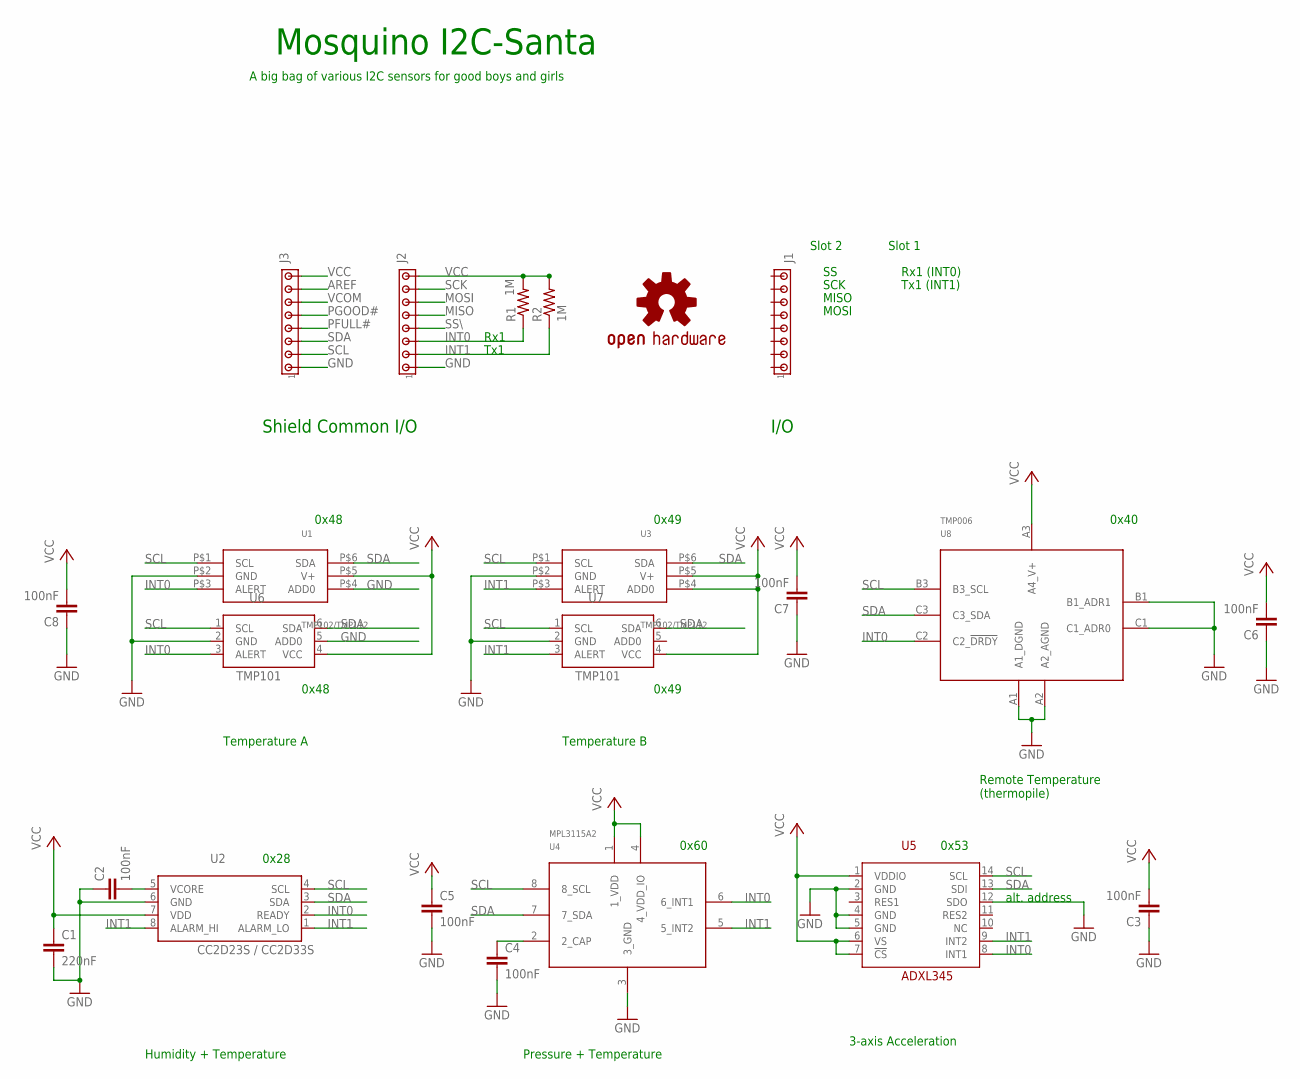
[picture p8: schematic shield-i2c-santa.sch]

Parts:
C1: 220nF; C0603
C2, C3, C4, C5, C6, C7, C8: 100nF; C0603
J1, J2, J3: MTA08-100; 10X08MTA
LOGO1: OSHW-LOGOS; OSHW-LOGO-S
R1, R2: 1M; R0603
U1, U3: TMP102/TMP112; SOT563
U2: CC2D23S / CC2D33S; CC2DXXX
U4: MPL3115A2; 8-LGA
U5: ADXL345; 14-LGA
U6, U7: TMP101; SOT23-6
U8: TMP006; 8-DSBGA

Connections:
AREF: J3.7
GND: C1.2, C2.1, C3.1, C4.2, C5.2, C6.1, C7.1, C8.1, J2.1, J3.1, U1.P$2 (GND), U1.P$4 (ADD0), U2.6 (GND), U3.P$2 (GND), U4.3 (3_GND), U5.2 (GND), U5.4 (GND), U5.5 (GND), U5.12 (SDO), U6.2 (GND), U6.5 (ADD0), U7.2 (GND), U8.A1 (A1_DGND), U8.A2 (A2_AGND), U8.B1 (B1_ADR1), U8.C1 (C1_ADR0)
INT0: J2.3, R1.1, U1.P$3 (ALERT), U2.2 (READY), U4.6 (6_INT1), U5.8 (INT1), U6.3 (ALERT), U8.C2 (C2_!DRDY)
INT1: J2.2, R2.1, U2.1 (ALARM_LO), U2.8 (ALARM_HI), U3.P$3 (ALERT), U4.5 (5_INT2), U5.9 (INT2), U7.3 (ALERT)
MISO: J2.5
MOSI: J2.6
unnamed: C2.2, U2.5 (VCORE)
unnamed: C4.1, U4.2 (2_CAP)
PFULL#: J3.4
PGOOD#: J3.5
SCK: J2.7
SCL: J3.2, U1.P$1 (SCL), U2.4 (SCL), U3.P$1 (SCL), U4.8 (8_SCL), U5.14 (SCL), U6.1 (SCL), U7.1 (SCL), U8.B3 (B3_SCL)
SDA: J3.3, U1.P$6 (SDA), U2.3 (SDA), U3.P$6 (SDA), U4.7 (7_SDA), U5.13 (SDI), U6.6 (SDA), U7.6 (SDA), U8.C3 (C3_SDA)
SS\: J2.4
VCC: C1.1, C3.2, C5.1, C6.2, C7.2, C8.2, J2.8, J3.8, R1.2, R2.2, U1.P$5 (V+), U2.7 (VDD), U3.P$4 (ADD0), U3.P$5 (V+), U4.1 (1_VDD), U4.4 (4_VDD_IO), U5.1 (VDDIO), U5.6 (VS), U5.7 (!CS), U6.4 (VCC), U7.4 (VCC), U8.A3 (A4_V+)
VCOM: J3.6

Notes on the sheet:
Shield Common I/O
I/O
Mosquino I2C-Santa
A big bag of various I2C sensors for good boys and girls
SCK
MISO
MOSI
Rx1 (INT0)
Tx1 (INT1)
Slot 2
Slot 1
Tx1
Rx1
0x53
alt. address
0x48
0x49
0x40
0x28
0x60
Pressure + Temperature
3-axis Acceleration
Humidity + Temperature
Remote Temperature (thermopile)
Temperature A
Temperature B

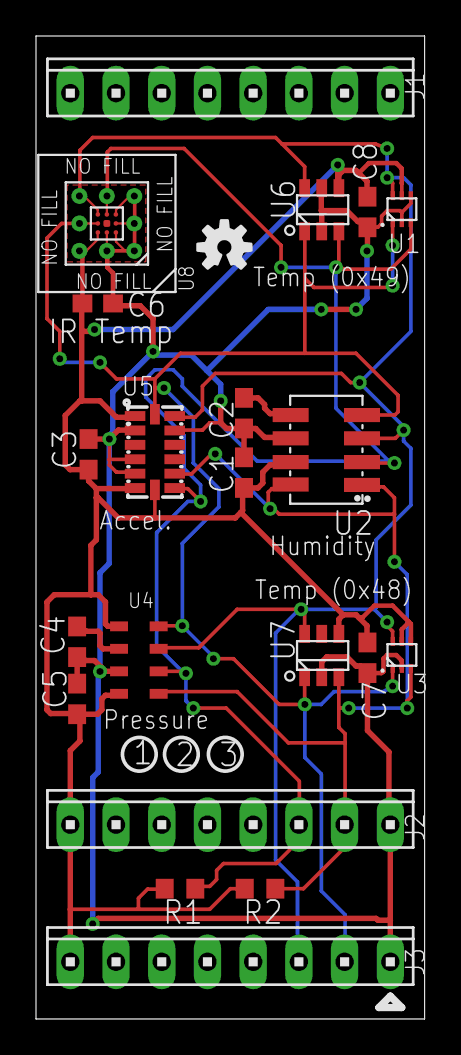
[picture p9: board shield-i2c-santa.brd from above]

Board: 2 copper layers, 21.6 x 54.6 mm, 22 parts (0 on the bottom side), 8 nets.
