drmn4ea/mosquino.hardware/main/mosquino.brd

## EAGLE design main/mosquino.brd (2012-06-12)

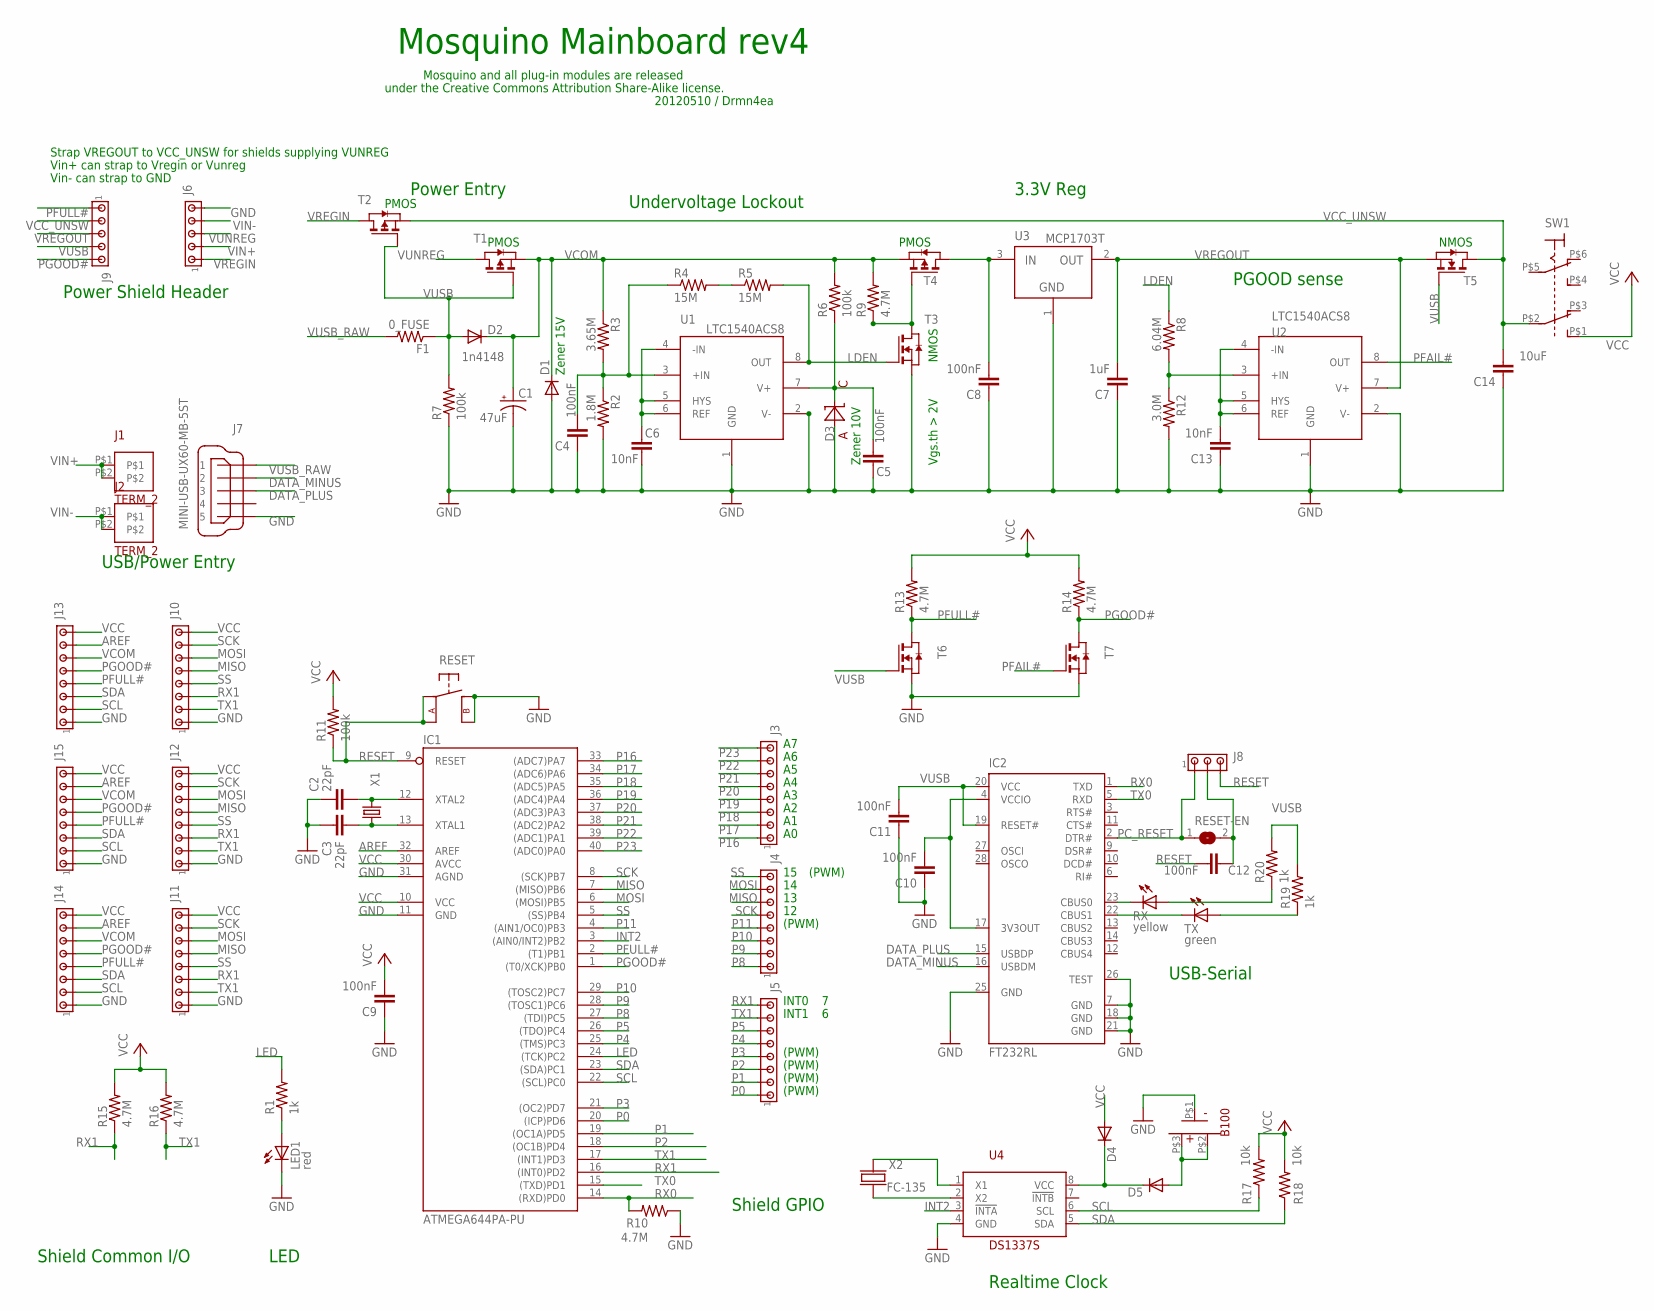
[picture p10: schematic mosquino.sch]

Parts:
B100: BK885_CR1225_COIN_BATTERY_HOLDER_SMD
C1: 47uF; PANASONIC_D
C2, C3: 22pF; C0805K
C4, C5, C8: 100nF; C0805
C6, C13: 10nF; C0805
C7: 1uF; C0805
C9, C10, C11, C12: 100nF; C0805K
C14: 10uF; C0805K
D1: BZT52C15-7-F; SOD123
D2: 1n4148; SOD123
D3: BZT52C10-7-F; SOD123
D4, D5: MMSD301T1G; SOD123
F1: 0_FUSE; R0805
IC1: ATMEGA644PA-PU; DIL40
IC2: FT232RL; SSOP28
J1, J2: TERM_2; TERM_3POINT5MM
J3, J4, J5, J10, J11, J12, J13, J14, J15: MTA08-100; 10X08MTA
J6, J9: MTA05-100; 10X05MTA
J7: MINI-USB-UX60-MB-5ST; UX60-MB-5ST
J8: MTA03-100; 10X03MTA
LED1: red; CHIP-LED0805
R1, R19, R20: 1k; R0805
R2: 1.8M; R0805
R3: 3.65M; R0805
R4, R5: 15M; R0805
R6, R7, R11: 100k; R0805
R8: 6.04M; R0805
R9, R10, R13, R14, R15, R16: 4.7M; R0805
R12: 3.0M; R0805
R17, R18: 10k; R0805
RESET: EVQ_TACT_SW_6X6POINT5
RESET-EN: SJ
RX: yellow; CHIP-LED0805
SW1: SW_DPDT_EG1390; EG1390_SWITCH_DPDT
T1, T2, T4: DMP3098L-7; SOT-23
T3, T6, T7: IRFML8244TRPBF; SOT-23
T5: BSH103; SOT-23
TX: green; CHIP-LED0805
U1, U2: LTC1540ACS8; SO-8
U3: MCP1703T; SOT23
U4: DS1337S; SO-8
X1: ABLS-4.000MHZ-B4-T; SM49
X2: FC-135

Connections:
AREF: IC1.32 (AREF), J13.7, J14.7, J15.7
DATA_MINUS: IC2.16 (USBDM), J7.2
DATA_PLUS: IC2.15 (USBDP), J7.3
GND: B100.P$1 (-), C1.-, C2.2, C3.1, C4.1, C5.1, C6.1, C7.1, C8.1, C9.1, C10.1, C11.1, C13.1, C14.1, D1.A, D3.A, IC1.11 (GND), IC1.31 (AGND), IC2.7 (GND), IC2.18 (GND), IC2.21 (GND), IC2.25 (GND), IC2.26 (TEST), J6.5, J7.5, J10.1, J11.1, J12.1, J13.1, J14.1, J15.1, LED1.C, R2.2, R7.1, R10.1, R12.2, RESET.B, RESET.B2 (B1), T3.2 (S), T6.2 (S), T7.2 (S), U1.1 (GND), U1.2 (V-), U2.1 (GND), U2.2 (V-), U3.1 (GND), U4.4 (GND)
INT2: IC1.3 ((AIN0/INT2)PB2), U4.3 (!INTA)
LDEN: R5.2, R8.1, T3.3 (G), U1.8 (OUT)
LED: IC1.24 ((TCK)PC2), R1.2
MISO: IC1.7 ((MISO)PB6), J4.6, J10.5, J11.5, J12.5
MOSI: IC1.6 ((MOSI)PB5), J4.7, J10.6, J11.6, J12.6
unnamed: C12.1, J8.2, RESET-EN.2
unnamed: C2.1, IC1.12 (XTAL2), X1.2
unnamed: LED1.A, R1.1
unnamed: IC2.22 (CBUS1), TX.C
unnamed: C3.2, IC1.13 (XTAL1), X1.1
unnamed: U4.2 (X2), X2.P$2 (X2)
unnamed: D4.C, D5.C, U4.8 (VCC)
unnamed: U4.1 (X1), X2.P$1 (X1)
unnamed: C10.2, IC2.4 (VCCIO), IC2.17 (3V3OUT)
unnamed: R20.1, RX.A
unnamed: C5.2, D3.C, R6.1, U1.7 (V+)
unnamed: C6.2, U1.4 (-IN), U1.5 (HYS), U1.6 (REF)
unnamed: IC2.23 (CBUS0), RX.C
unnamed: R19.1, TX.A
unnamed: B100.P$2 (+), B100.P$3 (+), D5.A
unnamed: C4.2, R2.1, R3.2, R4.1, U1.3 (+IN)
unnamed: C13.2, U2.4 (-IN), U2.5 (HYS), U2.6 (REF)
unnamed: R8.2, R12.1, U2.3 (+IN)
unnamed: C8.2, T4.1 (D), U3.3 (IN)
unnamed: R9.1, T3.1 (D), T4.3 (G)
unnamed: R4.2, R5.1
P0: IC1.20 ((ICP)PD6), J5.1
P1: IC1.19 ((OC1A)PD5), J5.2
P2: IC1.18 ((OC1B)PD4), J5.3
P3: IC1.21 ((OC2)PD7), J5.4
P4: IC1.25 ((TMS)PC3), J5.5
P5: IC1.26 ((TDO)PC4), J5.6
P8: IC1.27 ((TDI)PC5), J4.1
P9: IC1.28 ((TOSC1)PC6), J4.2
P10: IC1.29 ((TOSC2)PC7), J4.3
P11: IC1.4 ((AIN1/OC0)PB3), J4.4
P16: IC1.33 ((ADC7)PA7), J3.1
P17: IC1.34 ((ADC6)PA6), J3.2
P18: IC1.35 ((ADC5)PA5), J3.3
P19: IC1.36 ((ADC4)PA4), J3.4
P20: IC1.37 ((ADC3)PA3), J3.5
P21: IC1.38 ((ADC2)PA2), J3.6
P22: IC1.39 ((ADC1)PA1), J3.7
P23: IC1.40 ((ADC0)PA0), J3.8
PC_RESET: IC2.2 (DTR#), J8.1, RESET-EN.1
PFAIL#: T7.3 (G), U2.8 (OUT)
PFULL#: IC1.2 ((T1)PB1), J9.1, J13.4, J14.4, J15.4, R13.1, T6.1 (D)
PGOOD#: IC1.1 ((T0/XCK)PB0), J9.5, J13.5, J14.5, J15.5, R14.1, T7.1 (D)
RESET: C12.2, IC1.9 (RESET), J8.3, R11.1, RESET.A, RESET.A2 (A1)
RX0: IC1.14 ((RXD)PD0), IC2.1 (TXD), R10.2
RX1: IC1.16 ((INT0)PD2), J5.8, J10.3, J11.3, J12.3, R15.1
SCK: IC1.8 ((SCK)PB7), J4.5, J10.7, J11.7, J12.7
SCL: IC1.22 ((SCL)PC0), J13.2, J14.2, J15.2, R17.1, U4.6 (SCL)
SDA: IC1.23 ((SDA)PC1), J13.3, J14.3, J15.3, R18.1, U4.5 (SDA)
SS: IC1.5 ((SS)PB4), J4.8, J10.4, J11.4, J12.4
TX0: IC1.15 ((TXD)PD1), IC2.5 (RXD)
TX1: IC1.17 ((INT1)PD3), J5.7, J10.2, J11.2, J12.2, R16.1
VCC: C9.2, D4.A, IC1.10 (VCC), IC1.30 (AVCC), J10.8, J11.8, J12.8, J13.8, J14.8, J15.8, R11.2, R13.2, R14.2, R15.2, R16.2, R17.2, R18.2, SW1.P$1 (ON1)
VCC_UNSW: C14.2, J9.2, SW1.P$2 (COM1), T2.2 (S), T5.1 (D)
VCOM: C1.+, D1.C, D2.C, J13.6, J14.6, J15.6, R3.1, R6.2, R9.2, T1.2 (S), T4.2 (S)
VIN+: J1.P$1, J1.P$2, J6.2
VIN-: J2.P$1, J2.P$2, J6.4
VREGIN: J6.1, T2.1 (D)
VREGOUT: C7.2, J9.3, T5.2 (S), U2.7 (V+), U3.2 (OUT)
VUNREG: J6.3, T1.1 (D)
VUSB: C11.2, D2.A, F1.1, IC2.19 (RESET#), IC2.20 (VCC), J9.4, R7.2, R19.2, R20.2, T1.3 (G), T2.3 (G), T5.3 (G), T6.3 (G)
VUSB_RAW: F1.2, J7.1

Notes on the sheet:
INT1
INT0
PMOS
Mosquino Mainboard rev4
20120510 / Drmn4ea
Strap VREGOUT to VCC_UNSW for shields supplying VUNREG
Vin+ can strap to Vregin or Vunreg
Vin- can strap to GND
Power Entry
USB-Serial
Realtime Clock
Shield GPIO
Shield Common I/O
LED
Power Shield Header
USB/Power Entry
Mosquino and all plug-in modules are released
under the Creative Commons Attribution Share-Alike license.
Undervoltage Lockout
NMOS
Vgs.th > 2V
3.3V Reg
PGOOD sense
Zener 15V
Zener 10V
(PWM)

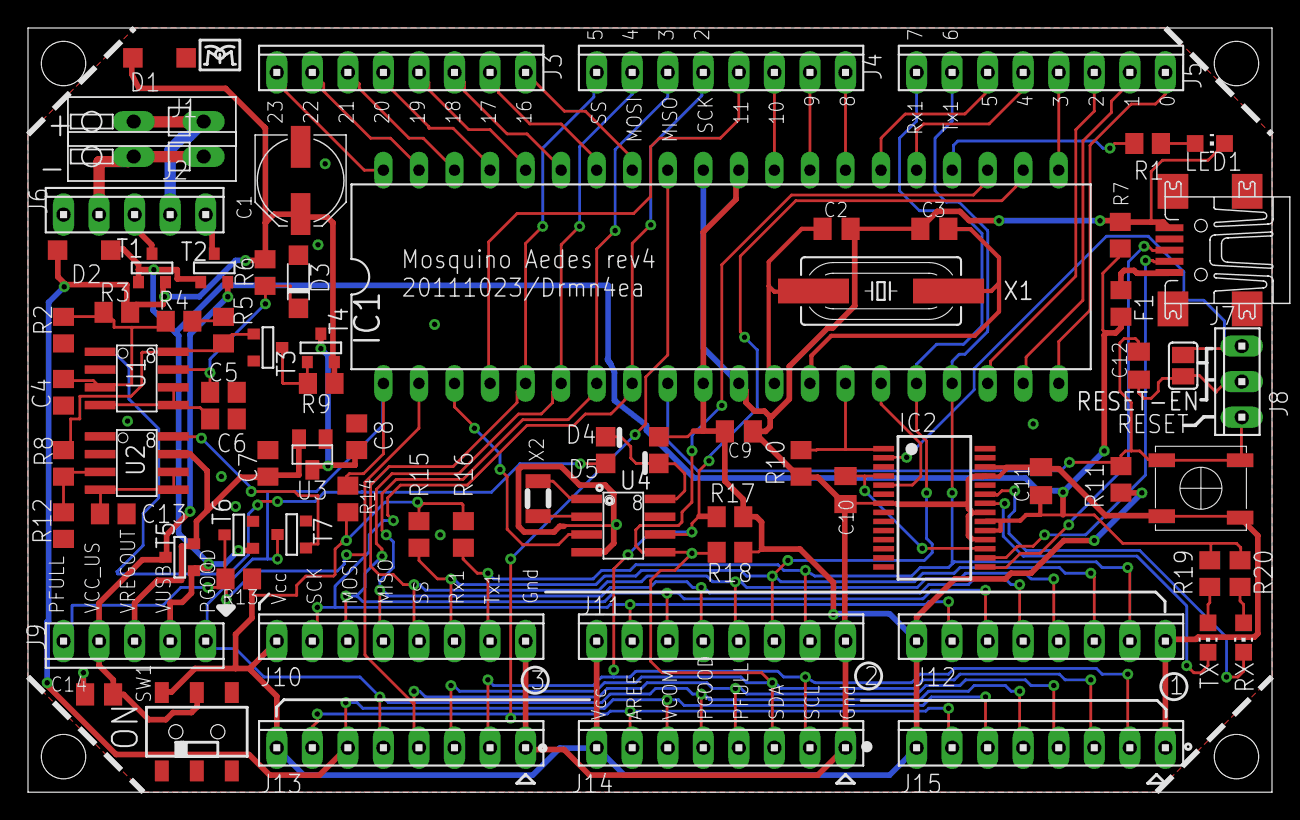
[picture p11: board mosquino.brd from above]

Board: 2 copper layers, 88.9 x 54.6 mm, 77 parts (1 on the bottom side), 71 nets.
