drmn4ea/mosquino.hardware/shield-template/shield.brd

## EAGLE design shield-template/shield.brd (2012-06-12)

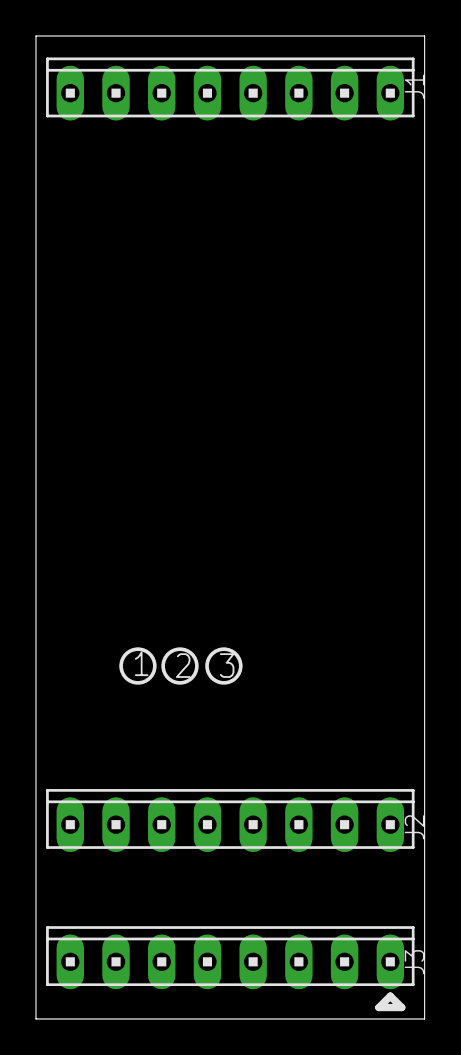
[picture p12: board shield.brd from above]

Board: 2 copper layers, 21.6 x 54.6 mm, 3 parts (0 on the bottom side), 2 nets, no tracks yet.

Parts:
J1, J2, J3: 10X08MTA

Connections:
GND: J2.1, J3.1
VCC: J2.8, J3.8
