drmn4ea/mosquino.hardware/(commit log)

2011-03-30 Add all current PCBs to hardware repository.
    [mosquino-power-piezo.brd, mosquino-power-piezo.sch, mosquino-power-pjt.brd, mosquino-power-pjt.sch, mosquino-power-pjt.xls, mosquino-pwr-peltier.brd, mosquino-pwr-peltier.sch, mosquino-pwr-peltier.xls]
2011-06-02 Reorganized (and added / removed) power shield pinout to include more important signals. Added PFULL# signal (supplants BUS_SENSE signal); PGOOD# and PFULL# are active-low, wired-OR. Fixed voltage dr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
    [mosquino.brd, mosquino.sch]
2011-06-02 First addition. Stackable power shield provides Li-Ion / LiPol / thinfilm battery support.
    [mosquino-power-lipol.brd, mosquino-power-lipol.sch]
2011-06-02 Added open-drain PGOOD#; clarified inductor "pin 1" markings
    [mosquino-pwr-peltier.brd, mosquino-pwr-peltier.sch, mosquino-pwr-peltier.xls]
2011-06-02 Added rectifier "boosted" mode jumper and FET for PGOOD#.
    [mosquino-power-piezo.brd, mosquino-power-piezo.sch, mosquino-pwr-piezo.xls]
2011-06-02 First addition. 0.6V to (1.8 ~ 5V) booster for solar (e.g. "AA" walk light) and other low-voltage sources.
    [mosquino-power-stepup.brd, mosquino-power-stepup.sch]
2011-06-02 First addition. Template and instructions for Mosquino power shields.
    [mosquino-power-template.brd, mosquino-power-template.sch]
2011-06-02 Updated Kent Displays bistable display shield for Mosquino rev2 pinout. Moved ribbon footprint and electronics so that the display can be placed without folding the ribbon.
    [shield-kentlcd.brd, shield-kentlcd.sch]
2011-06-02 Updated pinout for Mosquino rev2.
    [shield-microsd.brd, shield-microsd.sch]
2011-06-02 Updated pinout for Mosquino rev2. Updated explanatory text slightly.
    [shield.brd, shield.sch]
2011-06-02 Removed superfluous '+' symbols from mainboard. Flipped power shield PCBs in EAGLE for consistency with mainboard Added thermal vias to lipol board.
    [mosquino-power-lipol.brd, mosquino-power-lipol.sch, mosquino-power-piezo.brd, mosquino-pwr-peltier.brd, mosquino.brd]
2011-06-02 Adding gerbers to the repository.
    [mosquino-power-lipol.drills.xln, mosquino-power-piezo.drills.xln, mosquino-power-stepup.drills.xln, mosquino-pwr-peltier.drills.xln, mosquino.drills.xln, shield-kentlcd.drills.xln, shield-microsd.drills.xln]
2011-06-08 Added dummy values for unknown (not yet calculated) resistors so they will have unique lines when the BOM is generated. Fixed / cleaned up a couple part numbers (regulator, supervisor) to match the e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
    [mosquino.brd, mosquino.sch]
2011-06-08 Updated BOM to match rev2 final board.
    [mosquino.xls]
2011-06-18 Added BOM for lipol and stepup boards. Update schematics and BOM for several boards to include complete part#s and vendor part#.
    [mosquino-power-lipol.brd, mosquino-power-lipol.sch, mosquino-power-lipol.xls, mosquino-power-stepup.brd, mosquino-power-stepup.sch, mosquino-power-stepup.xls, mosquino-pwr-piezo.xls, shield-microsd.xls]
2011-07-20 Mainboard: Add proper resistor values to UVLO circuit, fix bottom solder mask, clean up silkscreen and bumped rev.
    [mosquino.brd, mosquino.sch]
2011-07-20 Kent LCD shield: Changed all passive component footprints from 0603 to 0805. Added descriptive text for J1 jumper.
    [shield-kentlcd.brd, shield-kentlcd.sch]
2012-01-25 Full power supply section redesign - now ~1uA in UVLO, ~6uA sleeping and supports voltages up to 15V; more reliable PGOOD and UVLO (on: 3.7V; off:3.3V) support. RESET pinned out near USB cable for ea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
    [mosquino.brd, mosquino.sch, mosquino.xls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]
2012-01-25 BOMs updated to share #s for common parts
    [mosquino-power-lipol.brd, mosquino-power-lipol.sch, mosquino-power-lipol.xls, mosquino-pwr-peltier.xls, mosquino-pwr-piezo.xls]
2012-01-25 Designed out obsolete Sparkfun card socket; added multi-socket compatible footprint and new part #s.
    [shield-microsd.brd, shield-microsd.sch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]
2012-02-07 Decouple VREF. Fix poorly-working PGOOD signal.
    [mosquino-power-stepup.brd, mosquino-power-stepup.sch, mosquino-power-stepup.xls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]
2012-02-07 First addition. NOTE: Completely untested as of 2/7/2011; waiting on boards!
    [mosquino-pwr-stepup-ti.brd, mosquino-pwr-stepup-ti.sch, mosquino-pwr-stepup-ti.xls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]
2012-02-07 First addition. I/O shield / Breakout board for ANT radio modules (AP2, AT3 recommended, although all currently sold have the same footprint).
    [shield-ant.brd, shield-ant.sch, shield-ant.xls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]
2012-03-27 Update the part variant listed for IC1 in schematic to match BOM. (This part comes in several minor variants with their pinouts flipped various ways)
    [mosquino-power-stepup.brd, mosquino-power-stepup.sch]
2012-06-12 No circuit changes for this commit. Mainboard: added schematic text indicating hardware PWM pins. Templates: Cleaned up explanatory text and/or silkscreen.
    [mosquino-power-template.brd, mosquino.brd, mosquino.sch, shield.brd]
2013-10-14 Add i2c-santa shield v1r0 to repository.
    [shield-i2c-santa.brd, shield-i2c-santa.sch, shield-i2c-santa.xls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]
2013-10-14 Added Bluetooth Low Energy shield v1r0 to repository.
    [shield-ble.brd, shield-ble.sch, shield-ble.xls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]
2013-10-14 Added RF power shield v1r0 to repository.
    [mosquino-power-rf.brd, mosquino-power-rf.sch, mosquino-power-rf.xls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]
2015-02-09 Add GPS shield to repository.
    [shield-gps.brd, shield-gps.sch, shield-gps.xls]
